Xenoah/pcb_voice-pitcher/docs/releases/v0.1.0-prototype.md

# Voice Pitcher Rev 0.1 — engineering prototype

98 × 98 mm・4層・表面実装のスタンドアローン音声DSP基板です。スクリーンショット全18枚を本文とAssetsに掲載しました。

これは実機未検証のプレリリースです。ERC/DRC/未接続は0件、ファームウェアのビルドとDSP合成音テストは通過しています。音質・遅延・USB互換性・消費電流は未測定で、量産承認済みではありません。

Assetsには全データZIP、ガーバーZIP、BOM/CPL、回路図、日本語説明書、ファームウェア、画像ZIPと個別PNGを含みます。`voice_pitcher_rev0.1_prototype.zip` でソースと製造資料を一括取得できます。部品調達とCPL方向のレビューを済ませてから試作してください。

実際のKiCadデータとPDFから出力した設計画面です。実機写真ではありません。3Dモデル未提供のJ1（USB-C）、J2/J3（音声ジャック）、Y1（発振器）、および外付けOLEDは3D表示に含まれません。

**3D斜視** — 98 × 98 mm、全ての部品を表面に実装する設計。

基板の3D斜視。CADレンダリング、未実機検証

**表裏・4層の一覧** — 上段は3D表裏、中段は表裏配線、下段はGND / 3.3 V内層。裏面図は裏側から見た向きです。

基板の表裏、配線、GNDと3.3V内層の一覧

**回路図全7ページと説明書** — 全体構成、MCU、電源、USB、コーデック、アナログ、表示・操作回路。

回路図全7ページと日本語説明書の一覧

<details>
<summary>個別の高解像度画像を表示</summary>

|3D表面|3D裏面|
|---|---|
|3D表面|3D裏面|
|表面配線|裏面配線|
|表面配線|裏面配線|
|L2 GND|L3 3.3 V|
|GND内層|3.3V内層|
|実装図|回路図：全体|
|実装図|全体構成|
|回路図：MCU|回路図：電源|
|MCU|電源|
|回路図：USB-C|回路図：コーデック|
|USB-C|コーデック|
|回路図：アナログ|回路図：OLED・スイッチ|
|アナログ|OLED・スイッチ|
|日本語説明書・先頭ページ|画像の生成元|
|日本語説明書|[CADハッシュ・3Dモデル出典・画像一覧](https://raw.githubusercontent.com/Xenoah/pcb_voice-pitcher/v0.1.0-prototype/downloads/screenshots/manifest.json)|

</details>
