Xenoah/pcb_voice-pitcher/downloads/bom_master.csv

ref | value | mpn | lcsc | footprint | assembly | sourcing_status | source_url
C1 | 100n | CC0603KRX7R9BB104 | C14663 | Capacitor_SMD:C_0603_1608Metric | SMT | BASIC | https://jlcpcb.com/partdetail/C14663
C2 | 10u | UWT1C100MCL1GB |  | Capacitor_SMD:CP_Elec_4x5.8 | SMT | UNVERIFIED
C3 | 10u | UWT1C100MCL1GB |  | Capacitor_SMD:CP_Elec_4x5.8 | SMT | UNVERIFIED
C4 | 100n | CC0603KRX7R9BB104 | C14663 | Capacitor_SMD:C_0603_1608Metric | SMT | BASIC | https://jlcpcb.com/partdetail/C14663
C5 | 10u | UWT1C100MCL1GB |  | Capacitor_SMD:CP_Elec_4x5.8 | SMT | UNVERIFIED
C6 | 100n | CC0603KRX7R9BB104 | C14663 | Capacitor_SMD:C_0603_1608Metric | SMT | BASIC | https://jlcpcb.com/partdetail/C14663
C7 | 100n | CC0603KRX7R9BB104 | C14663 | Capacitor_SMD:C_0603_1608Metric | SMT | BASIC | https://jlcpcb.com/partdetail/C14663
C8 | 100n | CC0603KRX7R9BB104 | C14663 | Capacitor_SMD:C_0603_1608Metric | SMT | BASIC | https://jlcpcb.com/partdetail/C14663
C9 | 100n | CC0603KRX7R9BB104 | C14663 | Capacitor_SMD:C_0603_1608Metric | SMT | BASIC | https://jlcpcb.com/partdetail/C14663
C10 | 100n | CC0603KRX7R9BB104 | C14663 | Capacitor_SMD:C_0603_1608Metric | SMT | BASIC | https://jlcpcb.com/partdetail/C14663
C11 | 100n | CC0603KRX7R9BB104 | C14663 | Capacitor_SMD:C_0603_1608Metric | SMT | BASIC | https://jlcpcb.com/partdetail/C14663
C12 | 100n | CC0603KRX7R9BB104 | C14663 | Capacitor_SMD:C_0603_1608Metric | SMT | BASIC | https://jlcpcb.com/partdetail/C14663
C13 | 1u | GRM188R71C105KA12D |  | Capacitor_SMD:C_0603_1608Metric | SMT | UNVERIFIED
C14 | 2.2u | GRM188R61C225KE15D |  | Capacitor_SMD:C_0603_1608Metric | SMT | UNVERIFIED
C15 | 2.2u | GRM188R61C225KE15D |  | Capacitor_SMD:C_0603_1608Metric | SMT | UNVERIFIED
C16 | 4.7u | GRM188R61C475KE11D |  | Capacitor_SMD:C_0603_1608Metric | SMT | UNVERIFIED
C17 | 100n | CC0603KRX7R9BB104 | C14663 | Capacitor_SMD:C_0603_1608Metric | SMT | BASIC | https://jlcpcb.com/partdetail/C14663
C18 | 100n | CC0603KRX7R9BB104 | C14663 | Capacitor_SMD:C_0603_1608Metric | SMT | BASIC | https://jlcpcb.com/partdetail/C14663
C19 | 100n | CC0603KRX7R9BB104 | C14663 | Capacitor_SMD:C_0603_1608Metric | SMT | BASIC | https://jlcpcb.com/partdetail/C14663
C20 | 100n | CC0603KRX7R9BB104 | C14663 | Capacitor_SMD:C_0603_1608Metric | SMT | BASIC | https://jlcpcb.com/partdetail/C14663
C21 | 10u | UWT1C100MCL1GB |  | Capacitor_SMD:CP_Elec_4x5.8 | SMT | UNVERIFIED
C22 | 100n | CC0603KRX7R9BB104 | C14663 | Capacitor_SMD:C_0603_1608Metric | SMT | BASIC | https://jlcpcb.com/partdetail/C14663
C23 | 100n | CC0603KRX7R9BB104 | C14663 | Capacitor_SMD:C_0603_1608Metric | SMT | BASIC | https://jlcpcb.com/partdetail/C14663
C24 | 470p | GRM1885C1H471JA01D |  | Capacitor_SMD:C_0603_1608Metric | SMT | UNVERIFIED
C25 | 4.7u | UWT1C4R7MCL1GB |  | Capacitor_SMD:CP_Elec_4x5.8 | SMT | UNVERIFIED
C26 | 2.2n | GRM1885C1H222JA01D |  | Capacitor_SMD:C_0603_1608Metric | SMT | UNVERIFIED
C29 | 470p | GRM1885C1H471JA01D |  | Capacitor_SMD:C_0603_1608Metric | SMT | UNVERIFIED
C30 | 4.7u | UWT1C4R7MCL1GB |  | Capacitor_SMD:CP_Elec_4x5.8 | SMT | UNVERIFIED
C31 | 2.2n | GRM1885C1H222JA01D |  | Capacitor_SMD:C_0603_1608Metric | SMT | UNVERIFIED
C34 | 100n | CC0603KRX7R9BB104 | C14663 | Capacitor_SMD:C_0603_1608Metric | SMT | BASIC | https://jlcpcb.com/partdetail/C14663
C35 | 1n | GRM1885C1H102JA01D |  | Capacitor_SMD:C_0603_1608Metric | SMT | UNVERIFIED
C36 | 10u | UWT1C100MCL1GB |  | Capacitor_SMD:CP_Elec_4x5.8 | SMT | UNVERIFIED
C40 | 1n | GRM1885C1H102JA01D |  | Capacitor_SMD:C_0603_1608Metric | SMT | UNVERIFIED
C41 | 10u | UWT1C100MCL1GB |  | Capacitor_SMD:CP_Elec_4x5.8 | SMT | UNVERIFIED
C42 | 100n | CC0603KRX7R9BB104 | C14663 | Capacitor_SMD:C_0603_1608Metric | SMT | BASIC | https://jlcpcb.com/partdetail/C14663
C43 | 100n | CC0603KRX7R9BB104 | C14663 | Capacitor_SMD:C_0603_1608Metric | SMT | BASIC | https://jlcpcb.com/partdetail/C14663
C44 | 100n | CC0603KRX7R9BB104 | C14663 | Capacitor_SMD:C_0603_1608Metric | SMT | BASIC | https://jlcpcb.com/partdetail/C14663
C45 | 100n | CC0603KRX7R9BB104 | C14663 | Capacitor_SMD:C_0603_1608Metric | SMT | BASIC | https://jlcpcb.com/partdetail/C14663
C46 | 100n | CC0603KRX7R9BB104 | C14663 | Capacitor_SMD:C_0603_1608Metric | SMT | BASIC | https://jlcpcb.com/partdetail/C14663
C47 | 1u | GRM188R71C105KA12D |  | Capacitor_SMD:C_0603_1608Metric | SMT | UNVERIFIED
C48 | 10n | GRM188R71E103KA01D |  | Capacitor_SMD:C_0603_1608Metric | SMT | UNVERIFIED
D1 | GREEN | LTST-C190KGKT |  | LED_SMD:LED_0603_1608Metric | SMT | UNVERIFIED
F1 | 500mA PTC | 1206L050YR |  | Fuse:Fuse_1206_3216Metric | SMT | UNVERIFIED
FB1 | 120R@100MHz | BLM21PG121SN1D |  | Inductor_SMD:L_0805_2012Metric | SMT | UNVERIFIED
FB2 | 120R@100MHz | BLM21PG121SN1D |  | Inductor_SMD:L_0805_2012Metric | SMT | UNVERIFIED
H1 | M3 NPTH | M3 NPTH |  | MountingHole:MountingHole_3.2mm_M3 | MECHANICAL | MECHANICAL
H2 | M3 NPTH | M3 NPTH |  | MountingHole:MountingHole_3.2mm_M3 | MECHANICAL | MECHANICAL
H3 | M3 NPTH | M3 NPTH |  | MountingHole:MountingHole_3.2mm_M3 | MECHANICAL | MECHANICAL
H4 | M3 NPTH | M3 NPTH |  | MountingHole:MountingHole_3.2mm_M3 | MECHANICAL | MECHANICAL
J1 | USB-C USB2 DEVICE | TYPE-C-31-M-12 | C165948 | Connector_USB:USB_C_Receptacle_HRO_TYPE-C-31-M-12 | SMT | JLC_LISTED | https://jlcpcb.com/partdetail/C165948
J2 | 3.5mm STEREO IN | SJ-3523-SMT-TR |  | Connector_Audio:Jack_3.5mm_CUI_SJ-3523-SMT_Horizontal | SMT | UNVERIFIED
J3 | 3.5mm STEREO OUT | SJ-3523-SMT-TR |  | Connector_Audio:Jack_3.5mm_CUI_SJ-3523-SMT_Horizontal | SMT | UNVERIFIED
J4 | OLED GND VCC SCL SDA | 1x4 2.54mm OLED socket |  | Connector_PinHeader_2.54mm:PinHeader_1x04_P2.54mm_Vertical | HAND | HAND
J5 | SWD | 1x6 2.54mm header |  | Connector_PinHeader_2.54mm:PinHeader_1x06_P2.54mm_Vertical | HAND | HAND
J6 | UART 3V3 | 1x3 2.54mm header |  | Connector_PinHeader_2.54mm:PinHeader_1x03_P2.54mm_Vertical | HAND | HAND
R1 | 5.1k | 0603WAF5101T5E | C23186 | Resistor_SMD:R_0603_1608Metric | SMT | BASIC | https://jlcpcb.com/partdetail/C23186
R2 | 5.1k | 0603WAF5101T5E | C23186 | Resistor_SMD:R_0603_1608Metric | SMT | BASIC | https://jlcpcb.com/partdetail/C23186
R3 | 1k | 0603WAF1001T5E | C21190 | Resistor_SMD:R_0603_1608Metric | SMT | BASIC | https://jlcpcb.com/partdetail/C21190
R4 | 1k | 0603WAF1001T5E | C21190 | Resistor_SMD:R_0603_1608Metric | SMT | BASIC | https://jlcpcb.com/partdetail/C21190
R5 | 22 | 0603WAF220JT5E | C23345 | Resistor_SMD:R_0603_1608Metric | SMT | BASIC | https://jlcpcb.com/partdetail/C23345
R6 | 22 | 0603WAF220JT5E | C23345 | Resistor_SMD:R_0603_1608Metric | SMT | BASIC | https://jlcpcb.com/partdetail/C23345
R7 | 100k | 0603WAF1003T5E | C25803 | Resistor_SMD:R_0603_1608Metric | SMT | BASIC | https://jlcpcb.com/partdetail/C25803
R8 | 100k | 0603WAF1003T5E | C25803 | Resistor_SMD:R_0603_1608Metric | SMT | BASIC | https://jlcpcb.com/partdetail/C25803
R9 | 33 | 0603WAF330JT5E | C23140 | Resistor_SMD:R_0603_1608Metric | SMT | JLC_LISTED | https://jlcpcb.com/partdetail/C23140
R10 | 10k | 0603WAF1002T5E | C25804 | Resistor_SMD:R_0603_1608Metric | SMT | BASIC | https://jlcpcb.com/partdetail/C25804
R11 | 10k | 0603WAF1002T5E | C25804 | Resistor_SMD:R_0603_1608Metric | SMT | BASIC | https://jlcpcb.com/partdetail/C25804
R12 | 220k | 0603WAF2203T5E | C22961 | Resistor_SMD:R_0603_1608Metric | SMT | JLC_LISTED | https://jlcpcb.com/partdetail/C22961
R13 | 10k | 0603WAF1002T5E | C25804 | Resistor_SMD:R_0603_1608Metric | SMT | BASIC | https://jlcpcb.com/partdetail/C25804
R14 | 33 | 0603WAF330JT5E | C23140 | Resistor_SMD:R_0603_1608Metric | SMT | JLC_LISTED | https://jlcpcb.com/partdetail/C23140
R15 | 33 | 0603WAF330JT5E | C23140 | Resistor_SMD:R_0603_1608Metric | SMT | JLC_LISTED | https://jlcpcb.com/partdetail/C23140
R16 | 33 | 0603WAF330JT5E | C23140 | Resistor_SMD:R_0603_1608Metric | SMT | JLC_LISTED | https://jlcpcb.com/partdetail/C23140
R17 | 33 | 0603WAF330JT5E | C23140 | Resistor_SMD:R_0603_1608Metric | SMT | JLC_LISTED | https://jlcpcb.com/partdetail/C23140
R20 | 10k | 0603WAF1002T5E | C25804 | Resistor_SMD:R_0603_1608Metric | SMT | BASIC | https://jlcpcb.com/partdetail/C25804
R21 | 10k | 0603WAF1002T5E | C25804 | Resistor_SMD:R_0603_1608Metric | SMT | BASIC | https://jlcpcb.com/partdetail/C25804
R22 | 100k | 0603WAF1003T5E | C25803 | Resistor_SMD:R_0603_1608Metric | SMT | BASIC | https://jlcpcb.com/partdetail/C25803
R23 | 100 | 0603WAF1000T5E | C22775 | Resistor_SMD:R_0603_1608Metric | SMT | BASIC | https://jlcpcb.com/partdetail/C22775
R25 | 10k | 0603WAF1002T5E | C25804 | Resistor_SMD:R_0603_1608Metric | SMT | BASIC | https://jlcpcb.com/partdetail/C25804
R26 | 10k | 0603WAF1002T5E | C25804 | Resistor_SMD:R_0603_1608Metric | SMT | BASIC | https://jlcpcb.com/partdetail/C25804
R27 | 100k | 0603WAF1003T5E | C25803 | Resistor_SMD:R_0603_1608Metric | SMT | BASIC | https://jlcpcb.com/partdetail/C25803
R28 | 100 | 0603WAF1000T5E | C22775 | Resistor_SMD:R_0603_1608Metric | SMT | BASIC | https://jlcpcb.com/partdetail/C22775
R30 | 3.3k | 0603WAF3301T5E | C22978 | Resistor_SMD:R_0603_1608Metric | SMT | BASIC | https://jlcpcb.com/partdetail/C22978
R31 | 100 | 0603WAF1000T5E | C22775 | Resistor_SMD:R_0603_1608Metric | SMT | BASIC | https://jlcpcb.com/partdetail/C22775
R32 | 100k | 0603WAF1003T5E | C25803 | Resistor_SMD:R_0603_1608Metric | SMT | BASIC | https://jlcpcb.com/partdetail/C25803
R35 | 3.3k | 0603WAF3301T5E | C22978 | Resistor_SMD:R_0603_1608Metric | SMT | BASIC | https://jlcpcb.com/partdetail/C22978
R36 | 100 | 0603WAF1000T5E | C22775 | Resistor_SMD:R_0603_1608Metric | SMT | BASIC | https://jlcpcb.com/partdetail/C22775
R37 | 100k | 0603WAF1003T5E | C25803 | Resistor_SMD:R_0603_1608Metric | SMT | BASIC | https://jlcpcb.com/partdetail/C25803
R40 | 4.7k | 0603WAF4701T5E | C23162 | Resistor_SMD:R_0603_1608Metric | SMT | BASIC | https://jlcpcb.com/partdetail/C23162
R41 | 4.7k | 0603WAF4701T5E | C23162 | Resistor_SMD:R_0603_1608Metric | SMT | BASIC | https://jlcpcb.com/partdetail/C23162
R42 | 10k | 0603WAF1002T5E | C25804 | Resistor_SMD:R_0603_1608Metric | SMT | BASIC | https://jlcpcb.com/partdetail/C25804
R43 | 10k | 0603WAF1002T5E | C25804 | Resistor_SMD:R_0603_1608Metric | SMT | BASIC | https://jlcpcb.com/partdetail/C25804
R44 | 10k | 0603WAF1002T5E | C25804 | Resistor_SMD:R_0603_1608Metric | SMT | BASIC | https://jlcpcb.com/partdetail/C25804
R45 | 10k | 0603WAF1002T5E | C25804 | Resistor_SMD:R_0603_1608Metric | SMT | BASIC | https://jlcpcb.com/partdetail/C25804
R46 | 1k | 0603WAF1001T5E | C21190 | Resistor_SMD:R_0603_1608Metric | SMT | BASIC | https://jlcpcb.com/partdetail/C21190
SW1 | RESET | TL3342F160QG |  | Button_Switch_SMD:SW_SPST_TL3342 | SMT | UNVERIFIED
SW2 | BOOT | TL3342F160QG |  | Button_Switch_SMD:SW_SPST_TL3342 | SMT | UNVERIFIED
SW3 | MODE | TL3342F160QG |  | Button_Switch_SMD:SW_SPST_TL3342 | SMT | UNVERIFIED
SW4 | DOWN | TL3342F160QG |  | Button_Switch_SMD:SW_SPST_TL3342 | SMT | UNVERIFIED
SW5 | UP | TL3342F160QG |  | Button_Switch_SMD:SW_SPST_TL3342 | SMT | UNVERIFIED
SW6 | IO | TL3342F160QG |  | Button_Switch_SMD:SW_SPST_TL3342 | SMT | UNVERIFIED
U1 | STM32H743VIT6 | STM32H743VIT6 | C114409 | Package_QFP:LQFP-100_14x14mm_P0.5mm | SMT | JLC_LISTED | https://jlcpcb.com/partdetail/C114409
U2 | PCM3060PWR | PCM3060PWR | C2651841 | Package_SO:TSSOP-28_4.4x9.7mm_P0.65mm | SMT | LCSC_LISTED_JLC_UNCONFIRMED | https://www.lcsc.com/product-detail/C2651841.html
U3 | USBLC6-2SC6 | USBLC6-2SC6 | C7519 | Package_TO_SOT_SMD:SOT-23-6 | SMT | JLC_LISTED | https://jlcpcb.com/partdetail/C7519
U4 | LD1117S33TR | LD1117S33TR |  | Package_TO_SOT_SMD:SOT-223-3_TabPin2 | SMT | UNVERIFIED
U5 | TLV9062IDR | TLV9062IDR |  | Package_SO:SOIC-8_3.9x4.9mm_P1.27mm | SMT | UNVERIFIED
U6 | TLV9062IDR | TLV9062IDR |  | Package_SO:SOIC-8_3.9x4.9mm_P1.27mm | SMT | UNVERIFIED
U7 | TPS22918DBVR | TPS22918DBVR |  | Package_TO_SOT_SMD:SOT-23-6 | SMT | UNVERIFIED
Y1 | 8MHz 3V3 CMOS | ASE-8.000MHZ-LC-T |  | Oscillator:Oscillator_SMD_Abracon_ASE-4Pin_3.2x2.5mm | SMT | UNVERIFIED
