Xenoah/pcb_voice-pitcher/docs/validation.md

# 検証記録と実機試験

## このリポジトリで実施済み

2026-11-01、Codex cloud environmentで実施。結果は `downloads/reports/` に保存しています。

|確認|結果|
|---|---|
|KiCad 9.0.2 ERC|0件|
|KiCad DRC / 未接続|0件 / 0件|
|回路図XMLとPCBの照合|377個の番号付きパッドを確認、意図的NCも照合|
|外形・層数・実装面|98 × 98 mm、4層、全107フットプリントTOP|
|BOMとCPL|SMT 100個のDesignator一致、ヘッダ・穴を除外|
|Arm GCC|Cortex-M7 hard-float、ELF/BIN/HEX生成成功|
|DSP単体|7音程のYIN検出、スケール選択、無音、NaN/範囲処理、長時間有限出力|
|デジタルDRY|入力floatと出力のバイト一致、24 bit整数→float→整数のサンプル照合|
|メモリ安全性|ホストのAddressSanitizer / UndefinedBehaviorSanitizerで検出なし|
|出力FFT|±12、+7、−5半音および単音補正2条件、全6条件で目標±15 cents以内|

FFTテストは3秒の合成正弦波を処理し、最初の1秒を除いた2秒を解析。今回の結果では全6条件で誤差1 cent未満です。音声・和音・過渡音の品質や、実機のアナログ性能を証明するものではありません。測定数値はJSONに保存しています。

ERCやDRCを黙らせるための一括違反除外は設定していません。PCM3060の多機能端子はハードウェアモードに合わせてDEMPを入力として表現し、未使用端子はNCにしています。電源入力には意図を明示するPWR_FLAGがあります。

## 実機で未検証の項目

試作前のレビュー項目と、試作後の合格条件を分けます。以下は結果欄が埋まるまで未完了です。

|順番|試験|確認内容・目標|
|---|---|---|
|1|無給電検査|5 V/3.3 VとGNDの短絡、極性、はんだブリッジ、取り付け方向|
|2|電源立ち上げ|電流制限5 V、3.3 V/VDDA/VCAP/VCOM、約26 msのスルー、異常発熱なし|
|3|電流と熱|未構成USB、構成後、単体、全エフェクト、OLED点灯、サスペンド各状態。LDO最高温度を記録|
|4|SWD・ブート|フラッシュverify、Reset、BOOT、異常時のリセット保持|
|5|クロック|HSE 8 MHz、MCLK 12.288 MHz、BCLK 3.072 MHz、LRCK 48 kHz、ジッタ・リンギング|
|6|デジタル音声|I²Sの24 bitとスロット位置、左右、符号、フルスケール、DMA処理期限|
|7|ラインDRY|1 kHz −12 dBFS相当から開始、左右利得・DC・クリップ点・周波数特性|
|8|音質|20 Hz～20 kHz、THD+N、SNR、クロストーク、電源/USB負荷変化。基板実測値を残す|
|9|遅延|ラインループバックのインパルス/相互相関、DRY/SHIFT/TUNE別、入力音程ごと|
|10|USB|Windows/macOS/Linux、必要なスマホ、入出力各ルート、48 kHz/24 bit、8時間連続、着脱・休止復帰|
|11|操作|4キーと長押し、表示欠落、OLEDなし、経路/モード切替時のポップ音|
|12|ピッチ補正|低音/高音/ビブラート/子音/雑音/和音。音程誤検出、フォルマント変化、帯域低下を試聴|

開発目標の目安はDRYアナログ往復3 ms未満、1 kHzでTHD+N −80 dB以下、A-weighted SNR 90 dB以上、各モードのDMA期限未超過です。これらは**受け入れ試験用の目標で、達成済み仕様ではありません**。ピッチ処理では品質と遅延の両方を記録して判断します。

USBのサスペンド電流、ESD/EMC、製品のVID/PID、部品代替、筐体機構は製品化時の追加作業です。現時点の `production_release` と `bench_validation` はどちらもfalseです。
