Xenoah/pcb_voice-pitcher/downloads/schematic.pdf

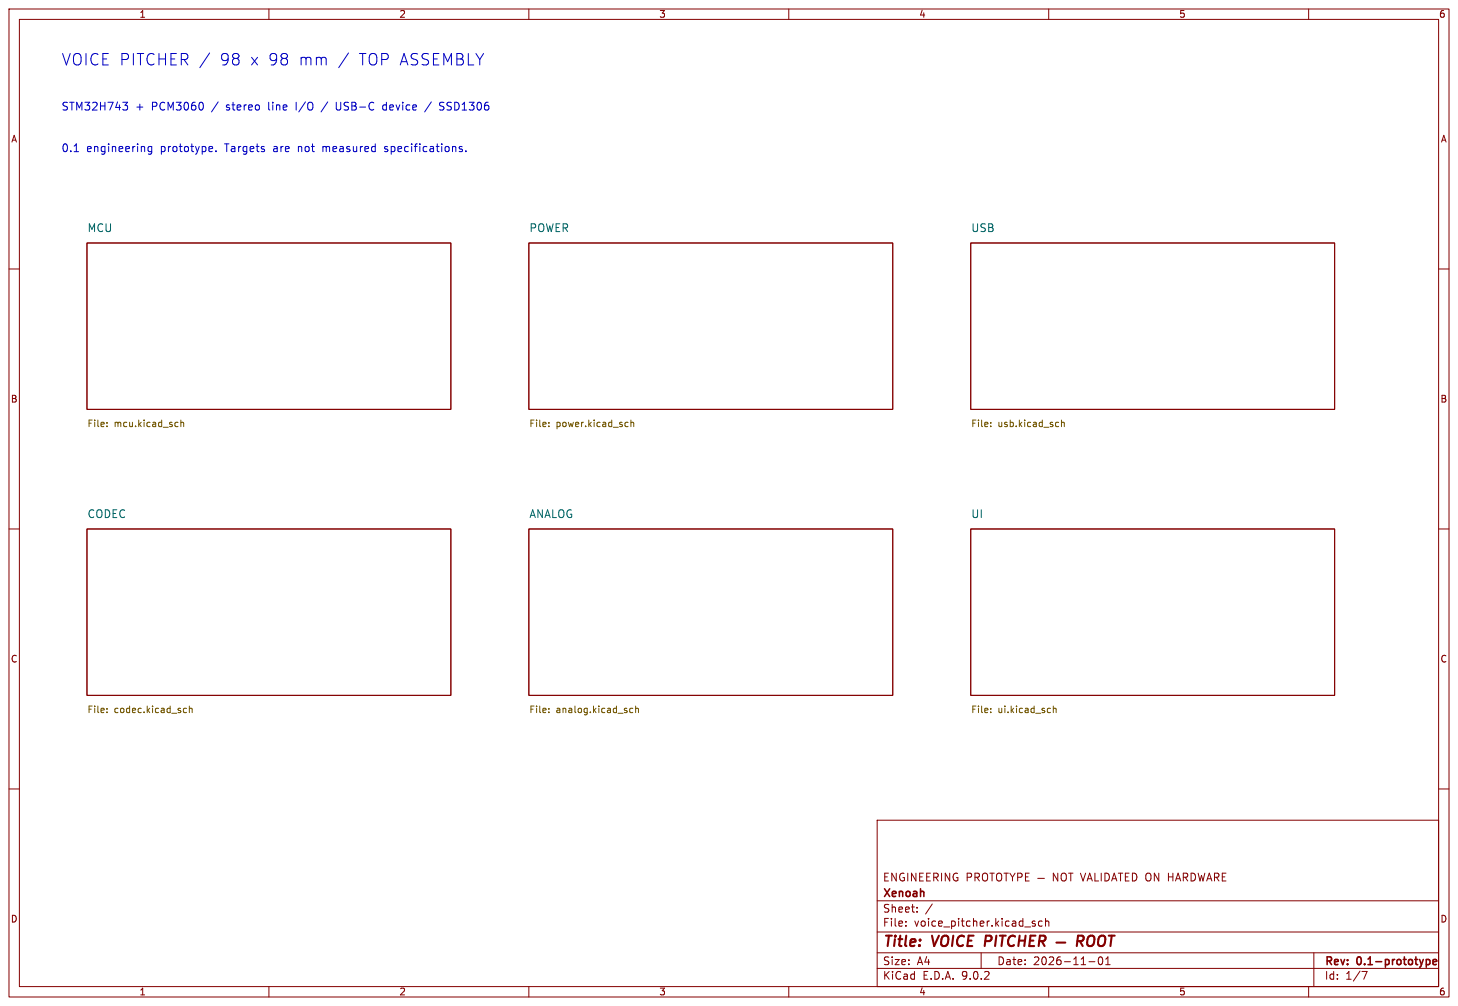
[picture p19: page 1]

Id: 1/7 Title: VOICE PITCHER þÿ ROOT

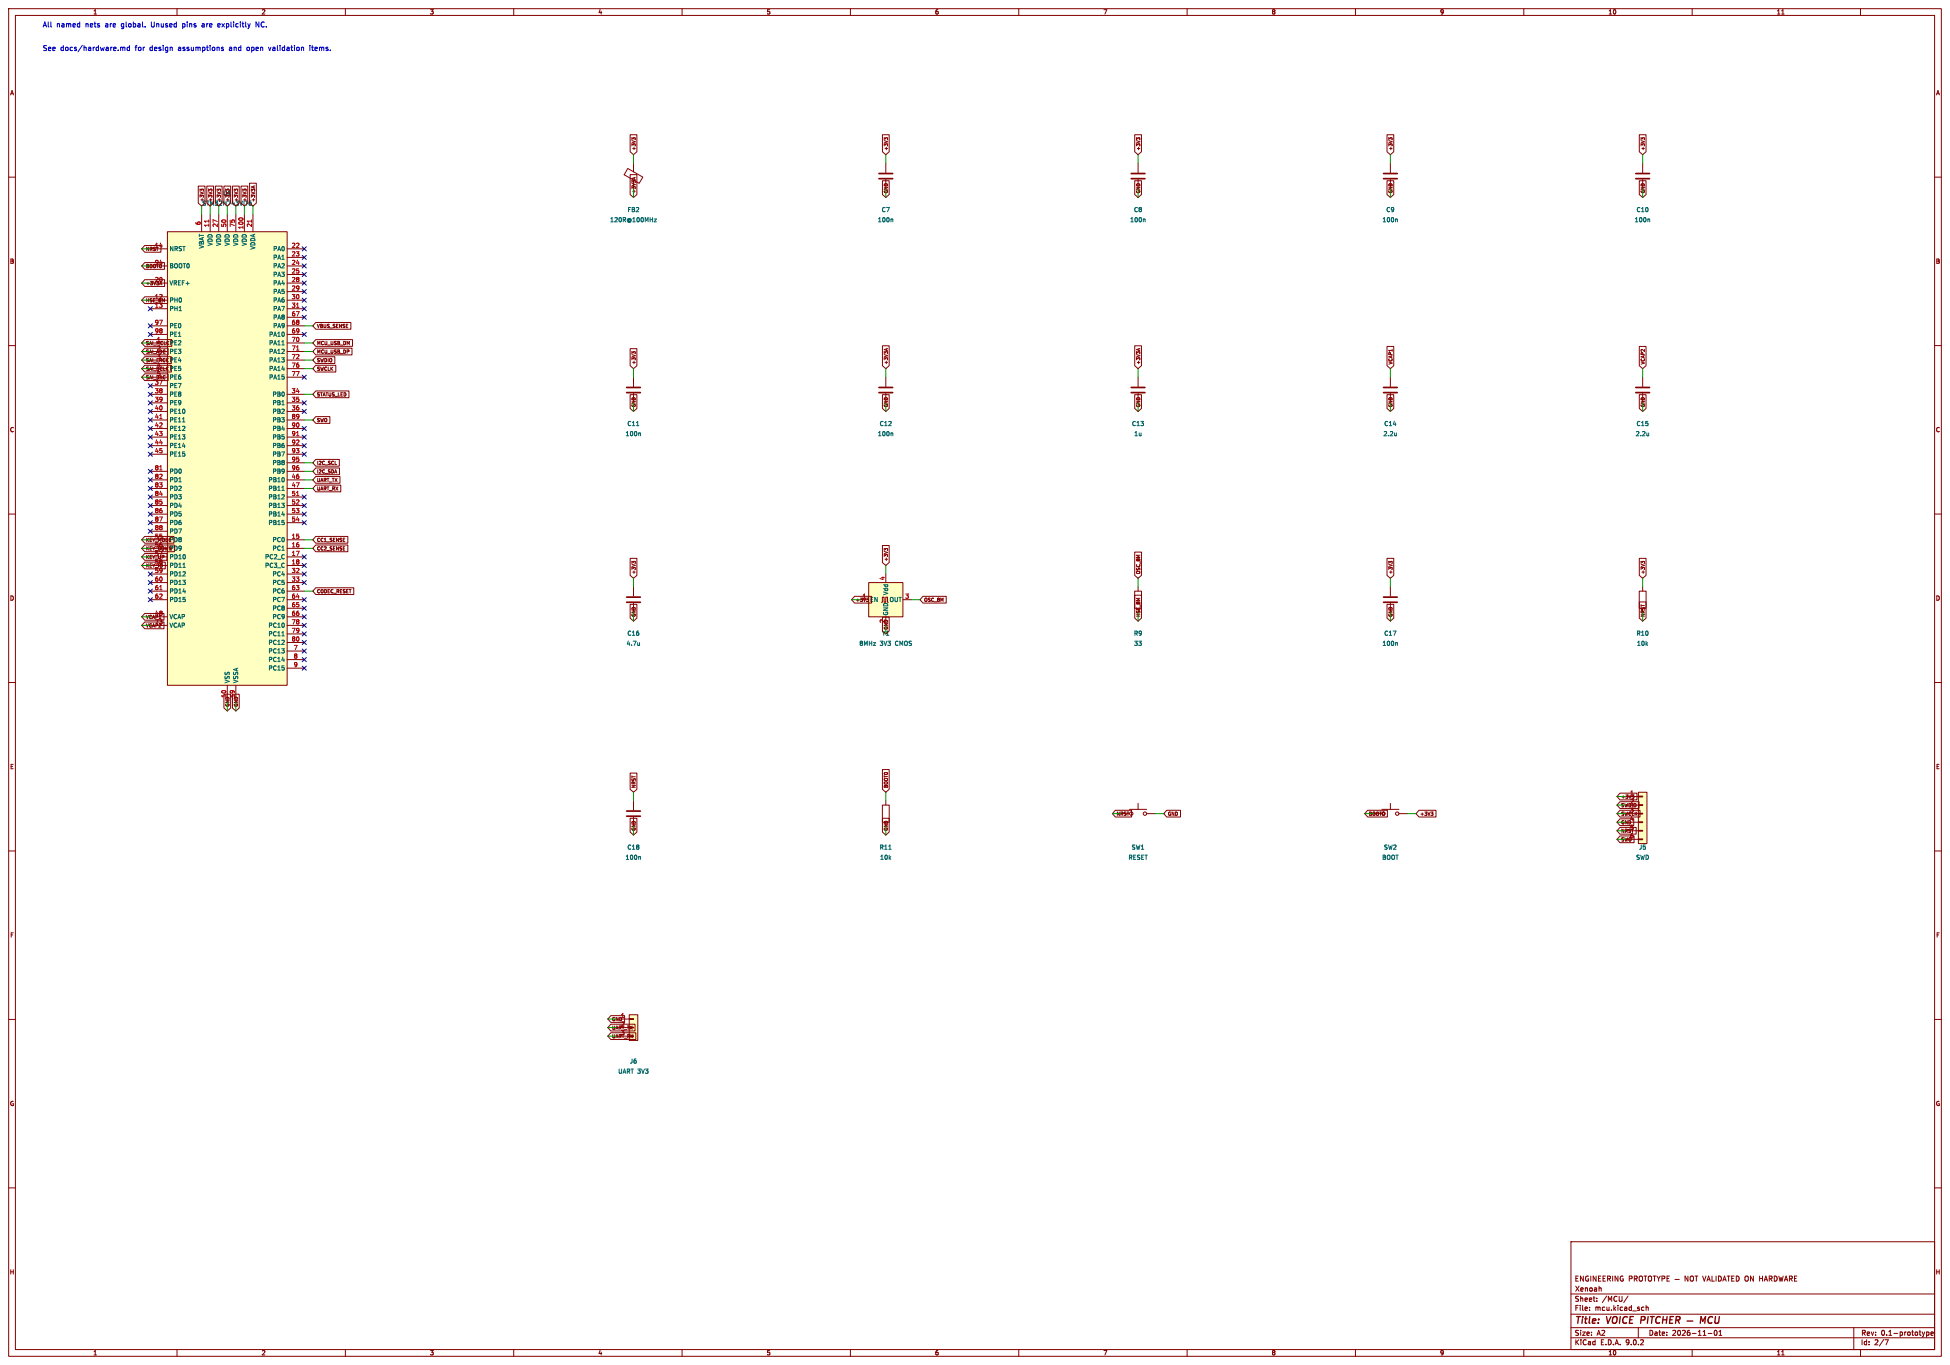
[picture p20: page 2]

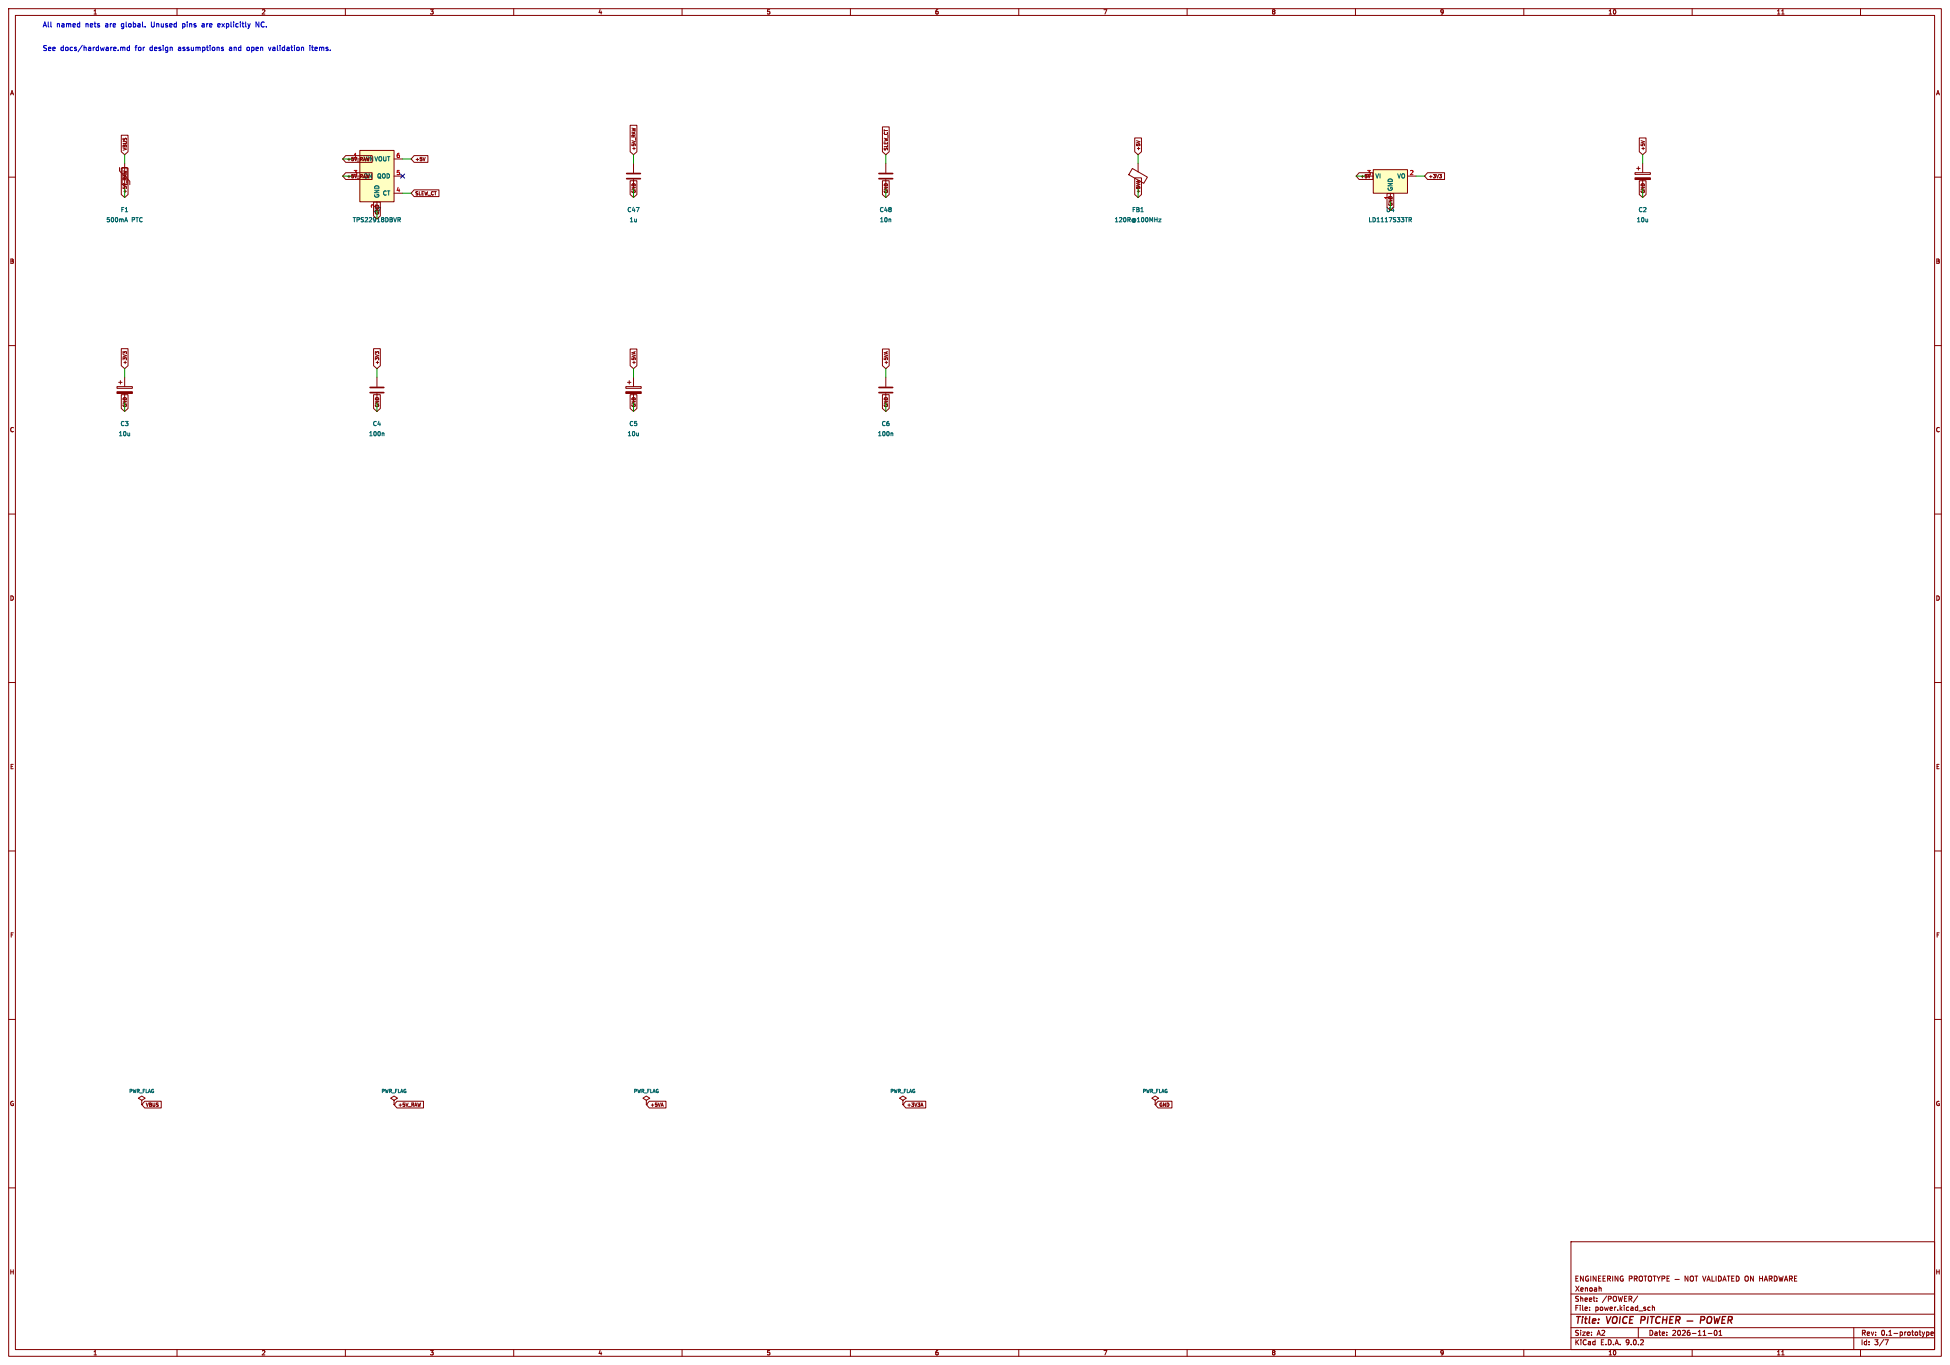
[picture p21: page 3]

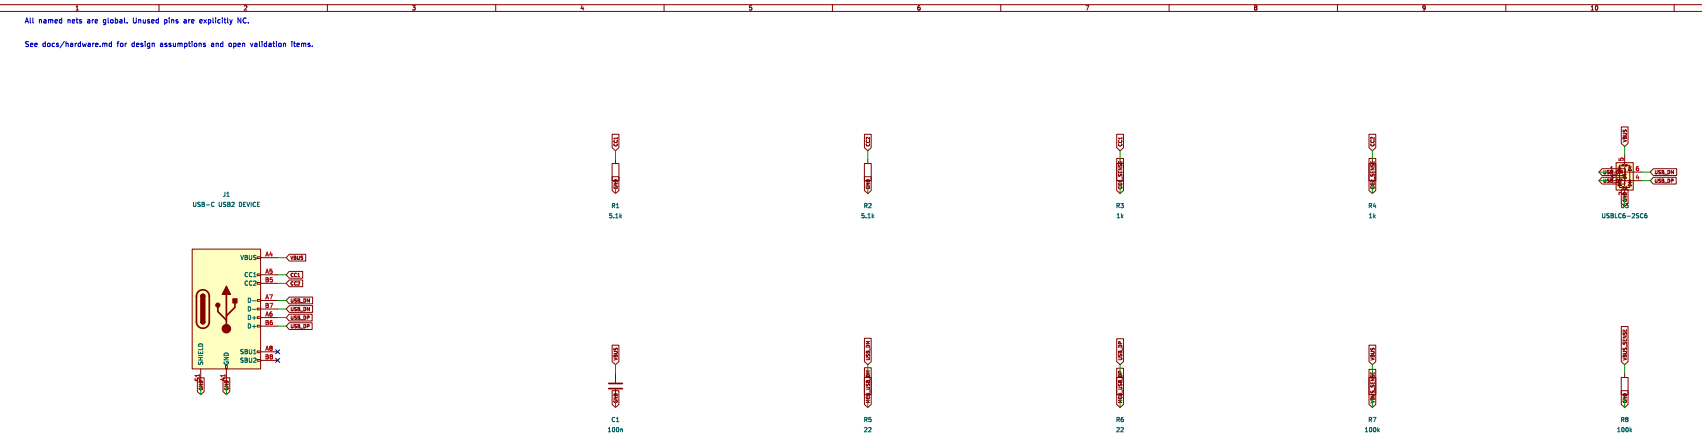
[picture p22: page 4]

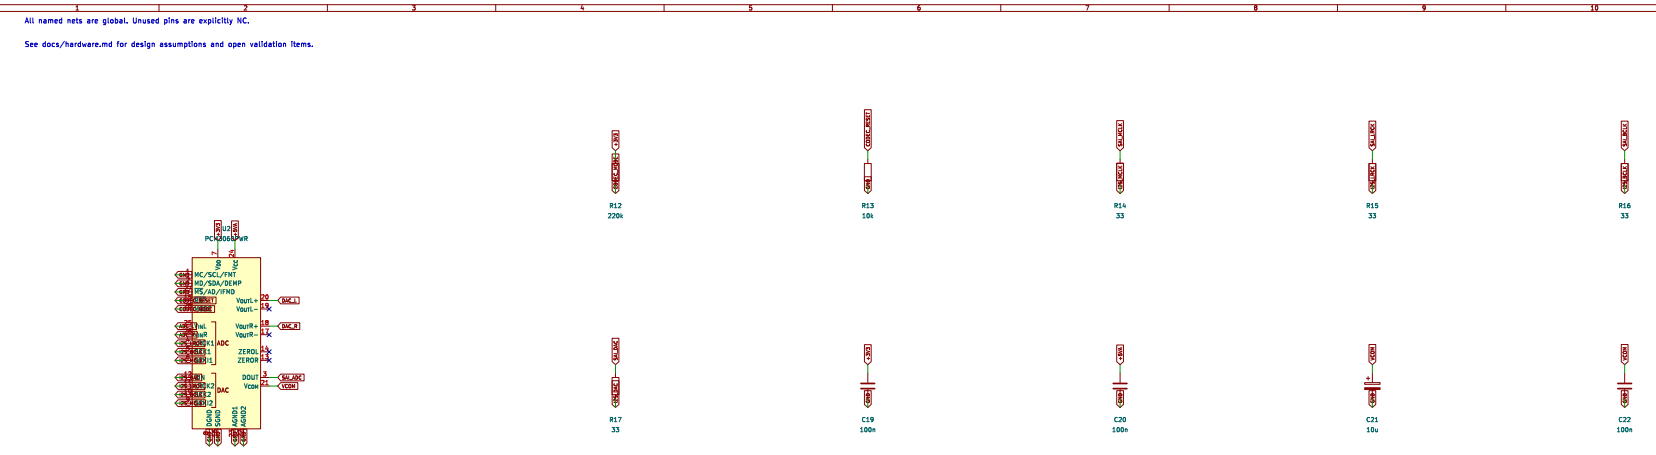
[picture p23: page 5]

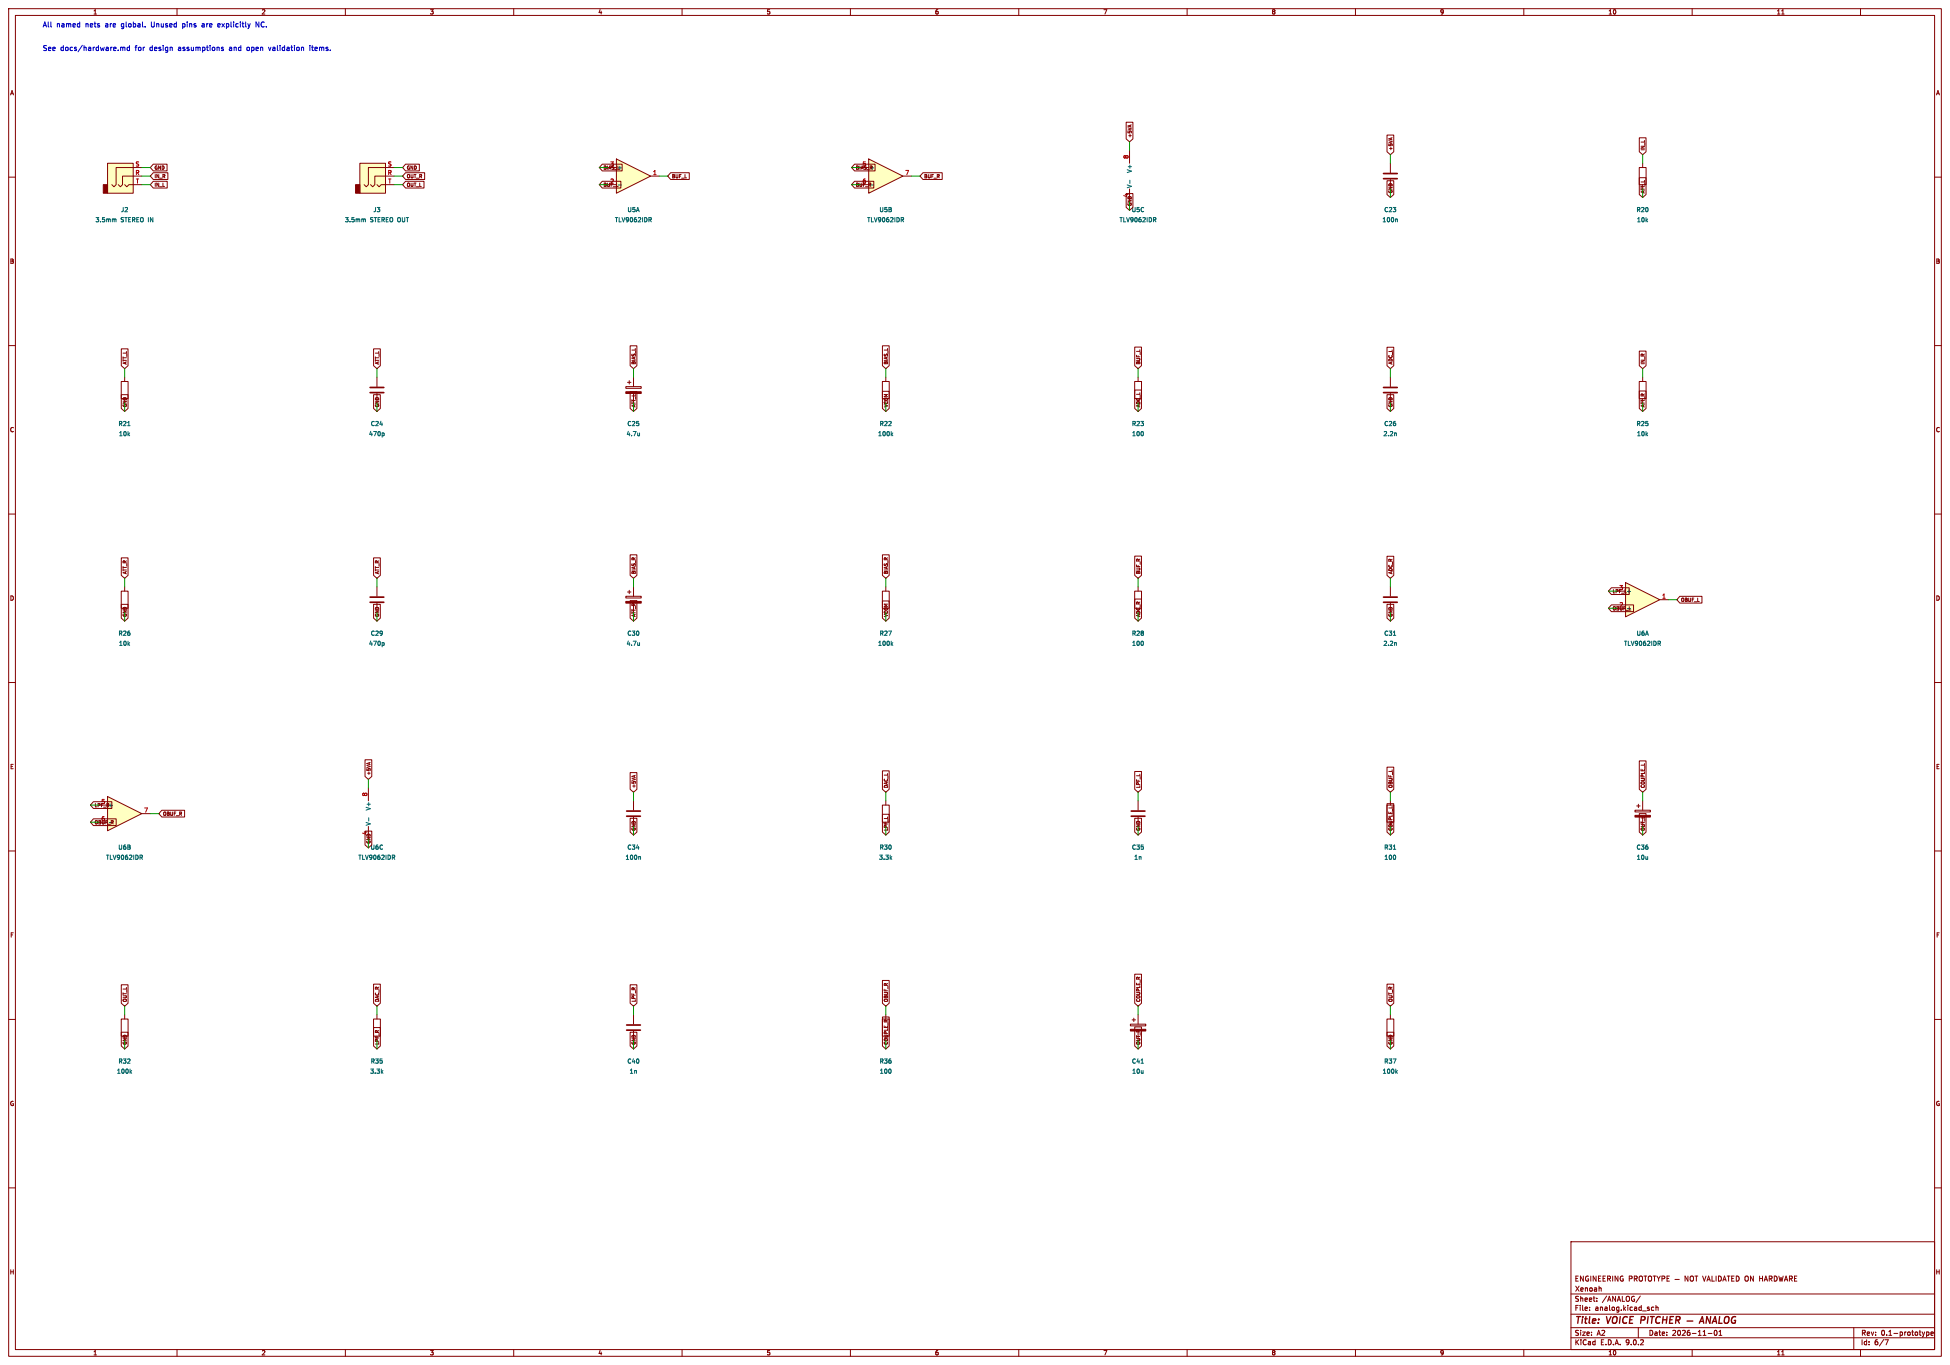
[picture p24: page 6]

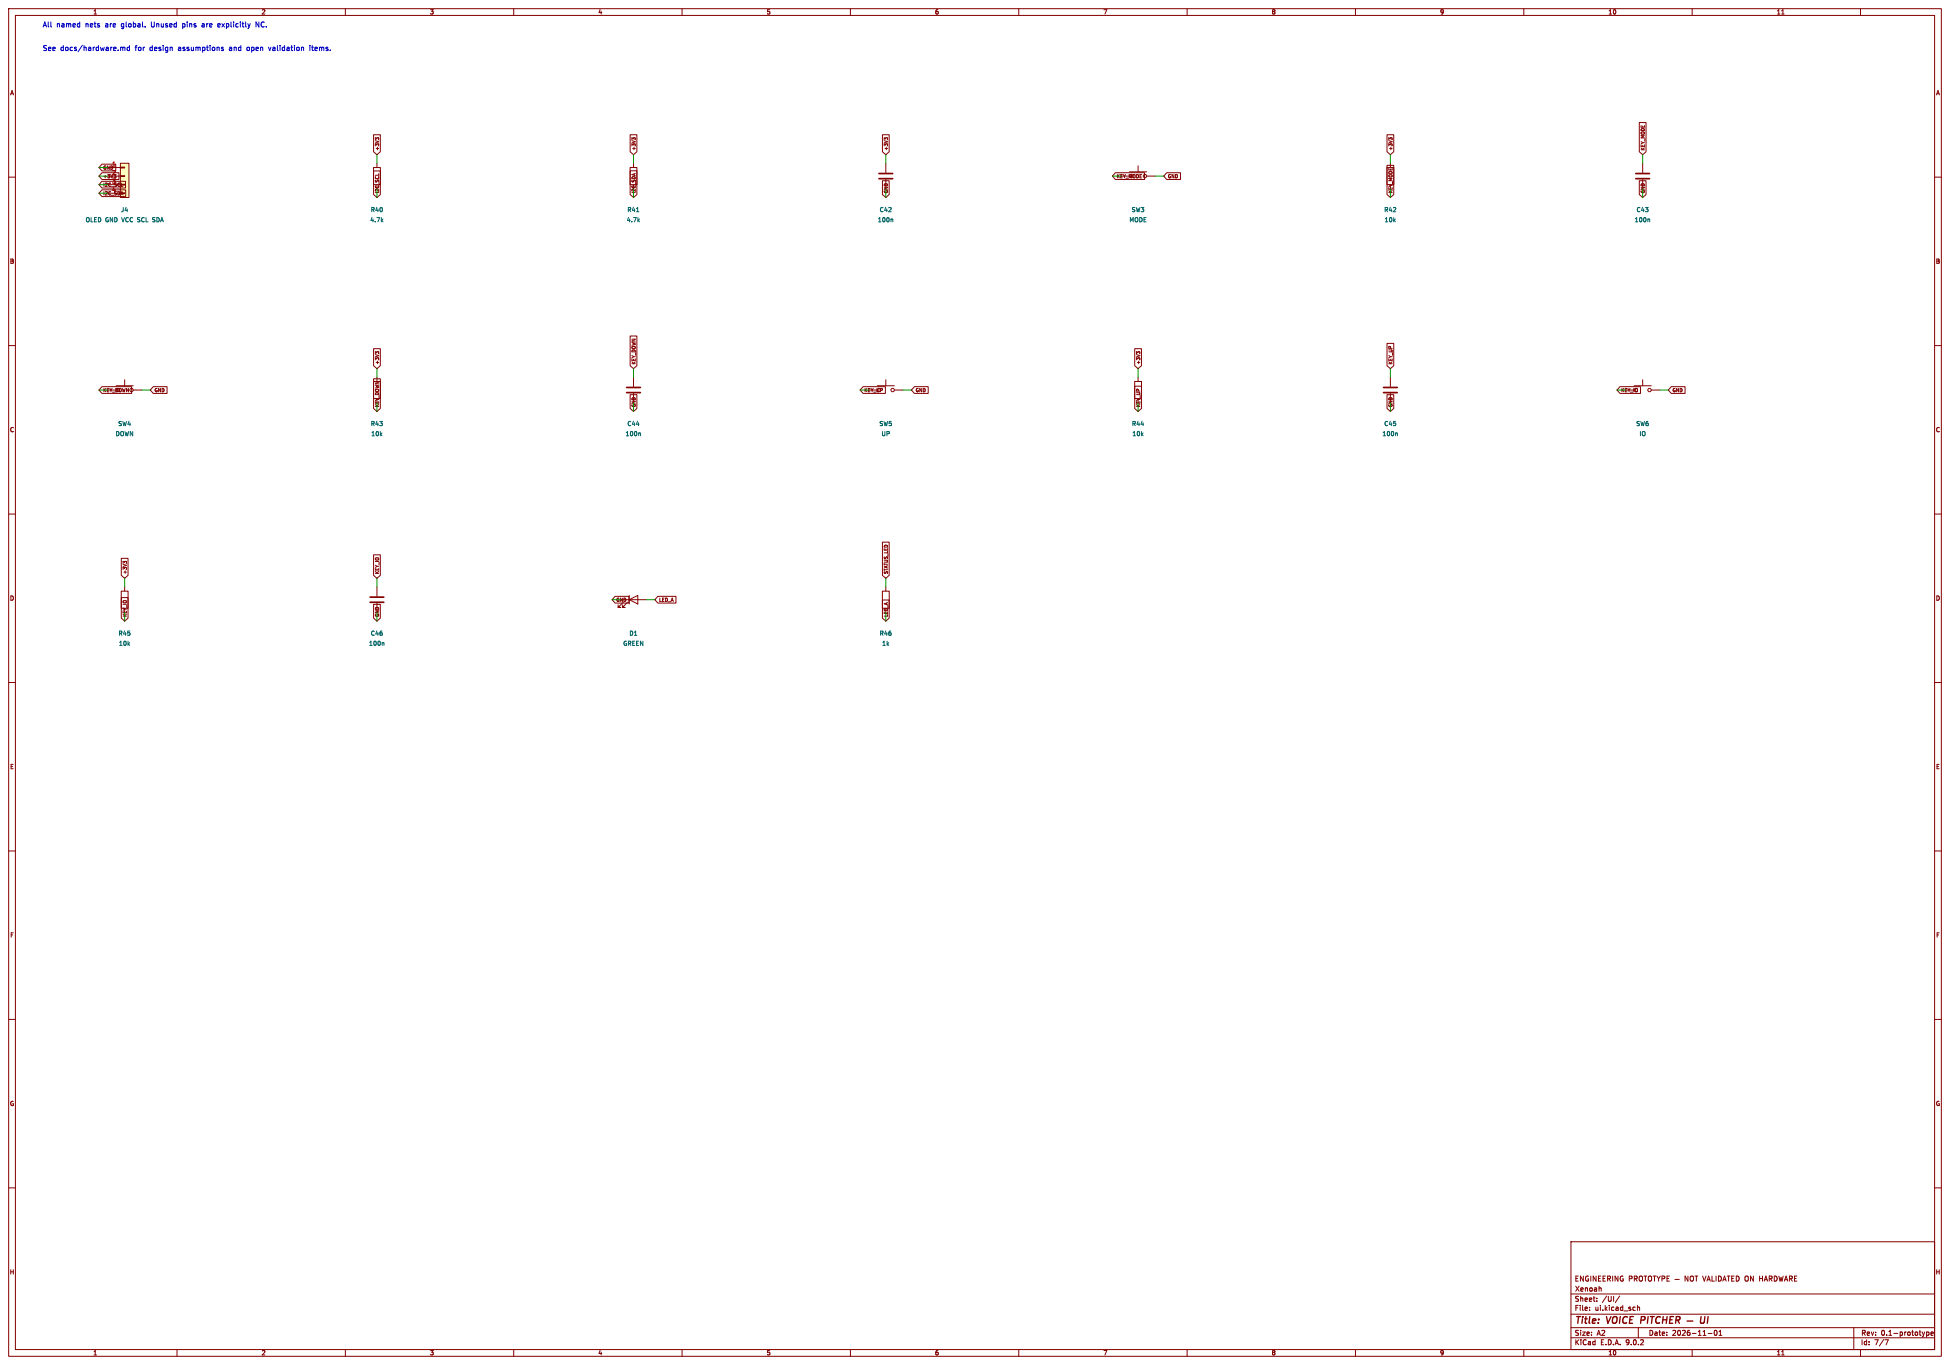
[picture p25: page 7]

J4 OLED GND VCC SCL SDA
