Xenoah/pcb_voice-pitcher/downloads/assembly-top.pdf

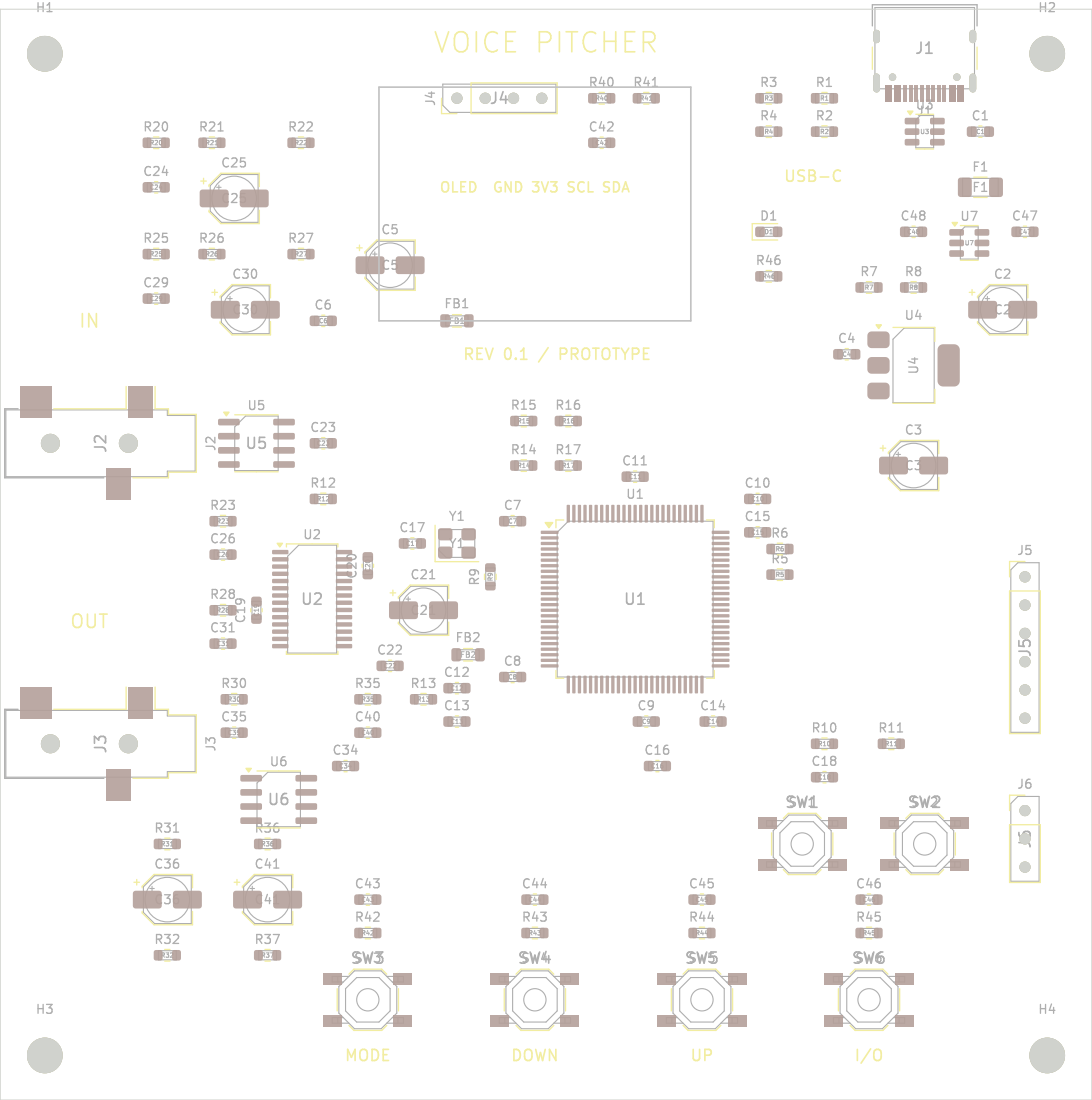
[picture p26: page 1]
