Xenoah/pcb_voice-pitcher/hardware/voice_pitcher.kicad_pcb

## KiCad design hardware/voice_pitcher.kicad_pcb (2026-11-01)

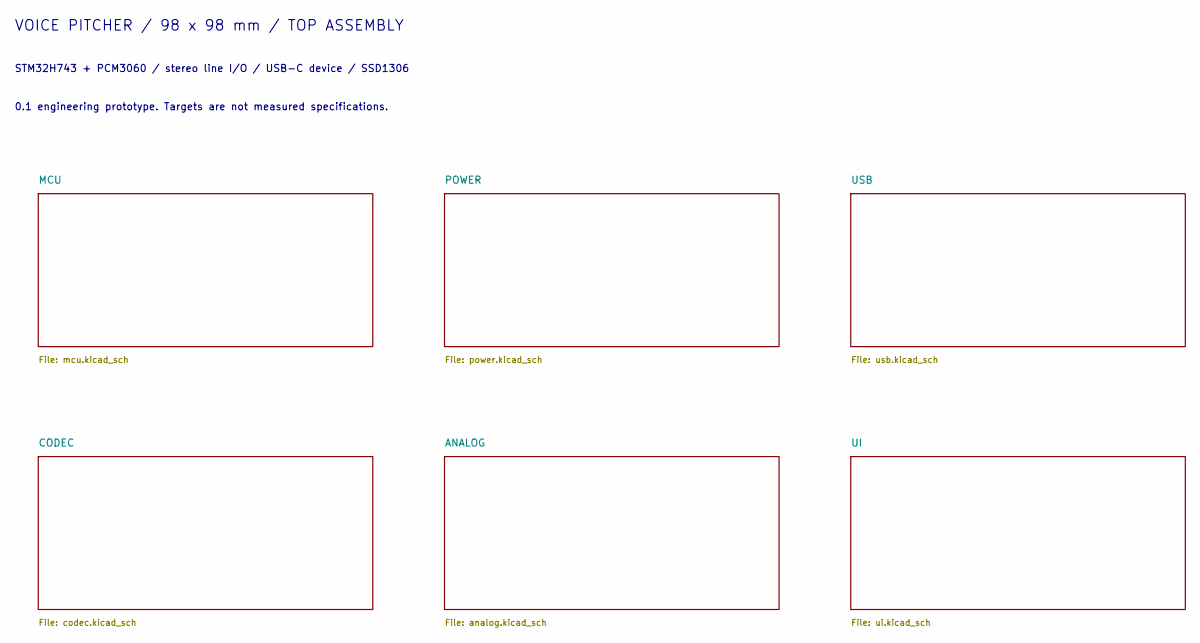
[picture p27: schematic voice_pitcher.kicad_sch, VOICE PITCHER — ROOT]

Notes on the sheet:
VOICE PITCHER / 98 x 98 mm / TOP ASSEMBLY
STM32H743 + PCM3060 / stereo line I/O / USB-C device / SSD1306
0.1 engineering prototype. Targets are not measured specifications.

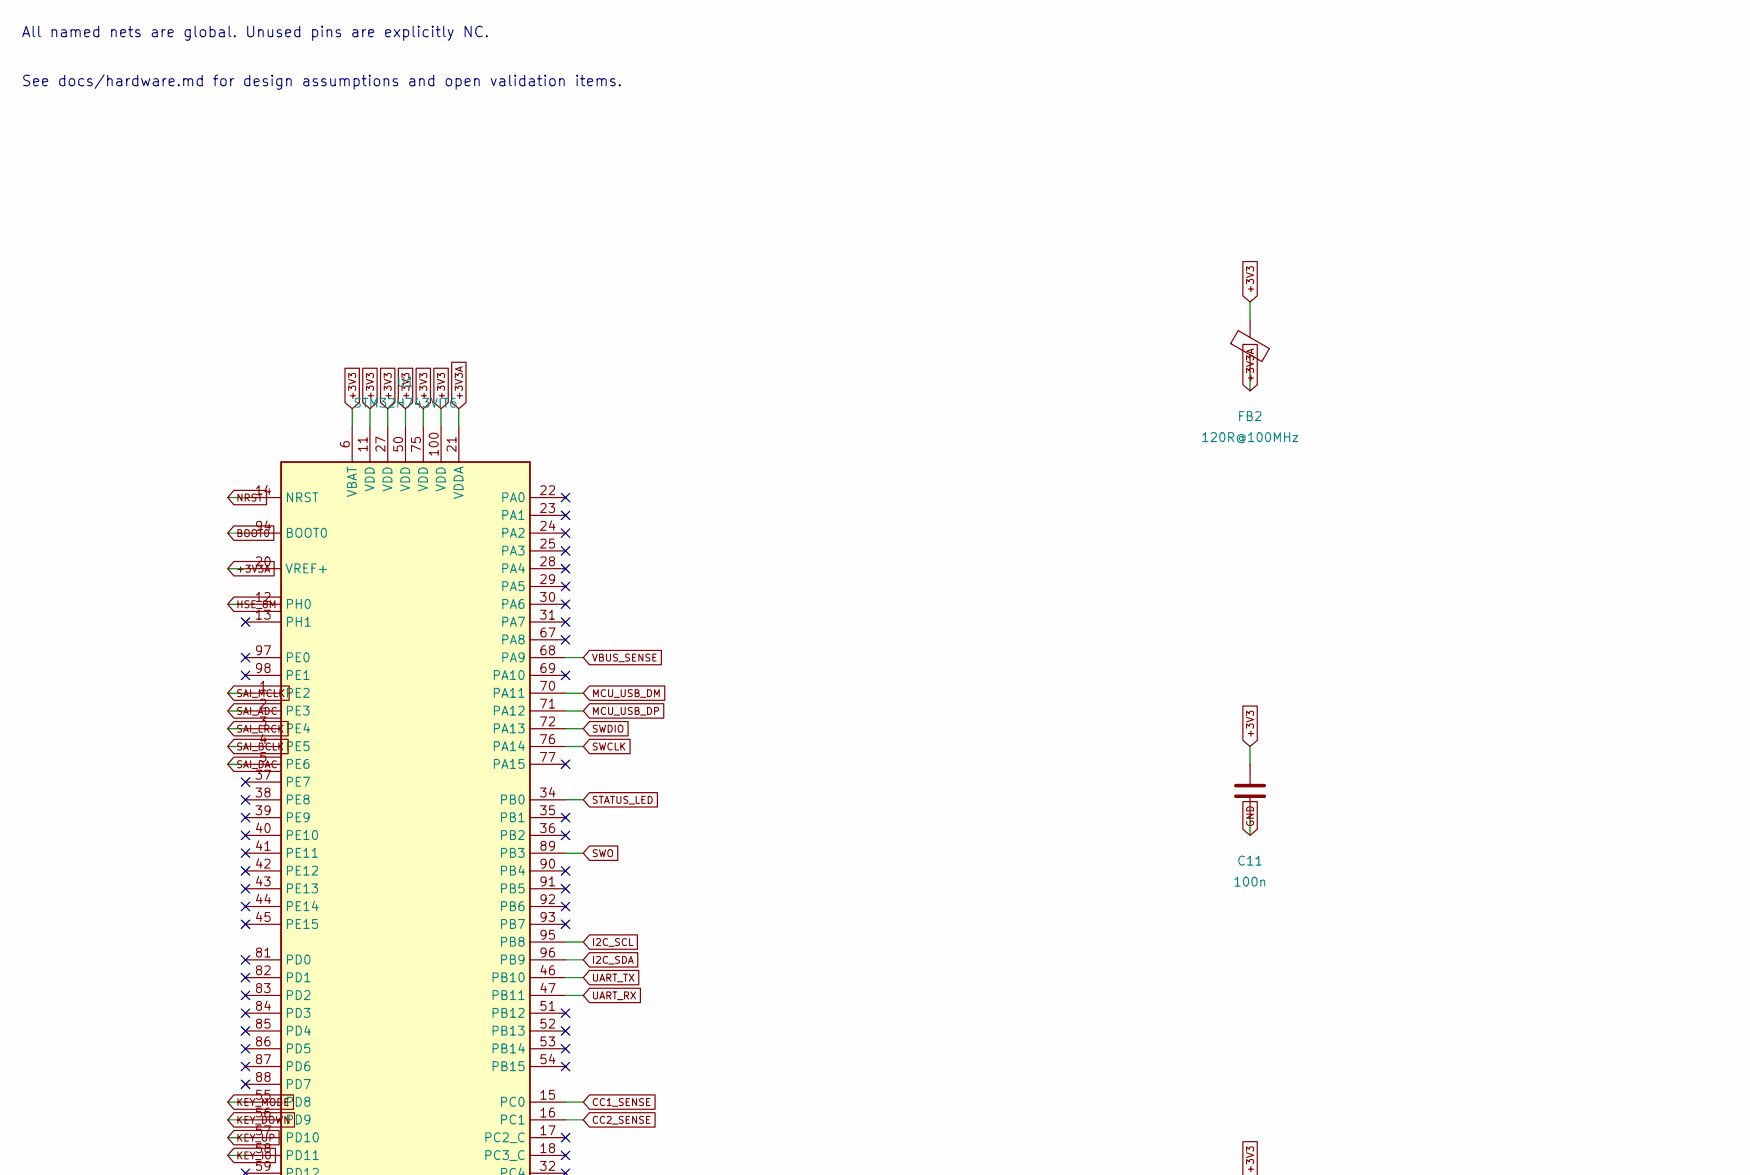
[picture p28: schematic mcu.kicad_sch, VOICE PITCHER — MCU, part in row 1, column 1]

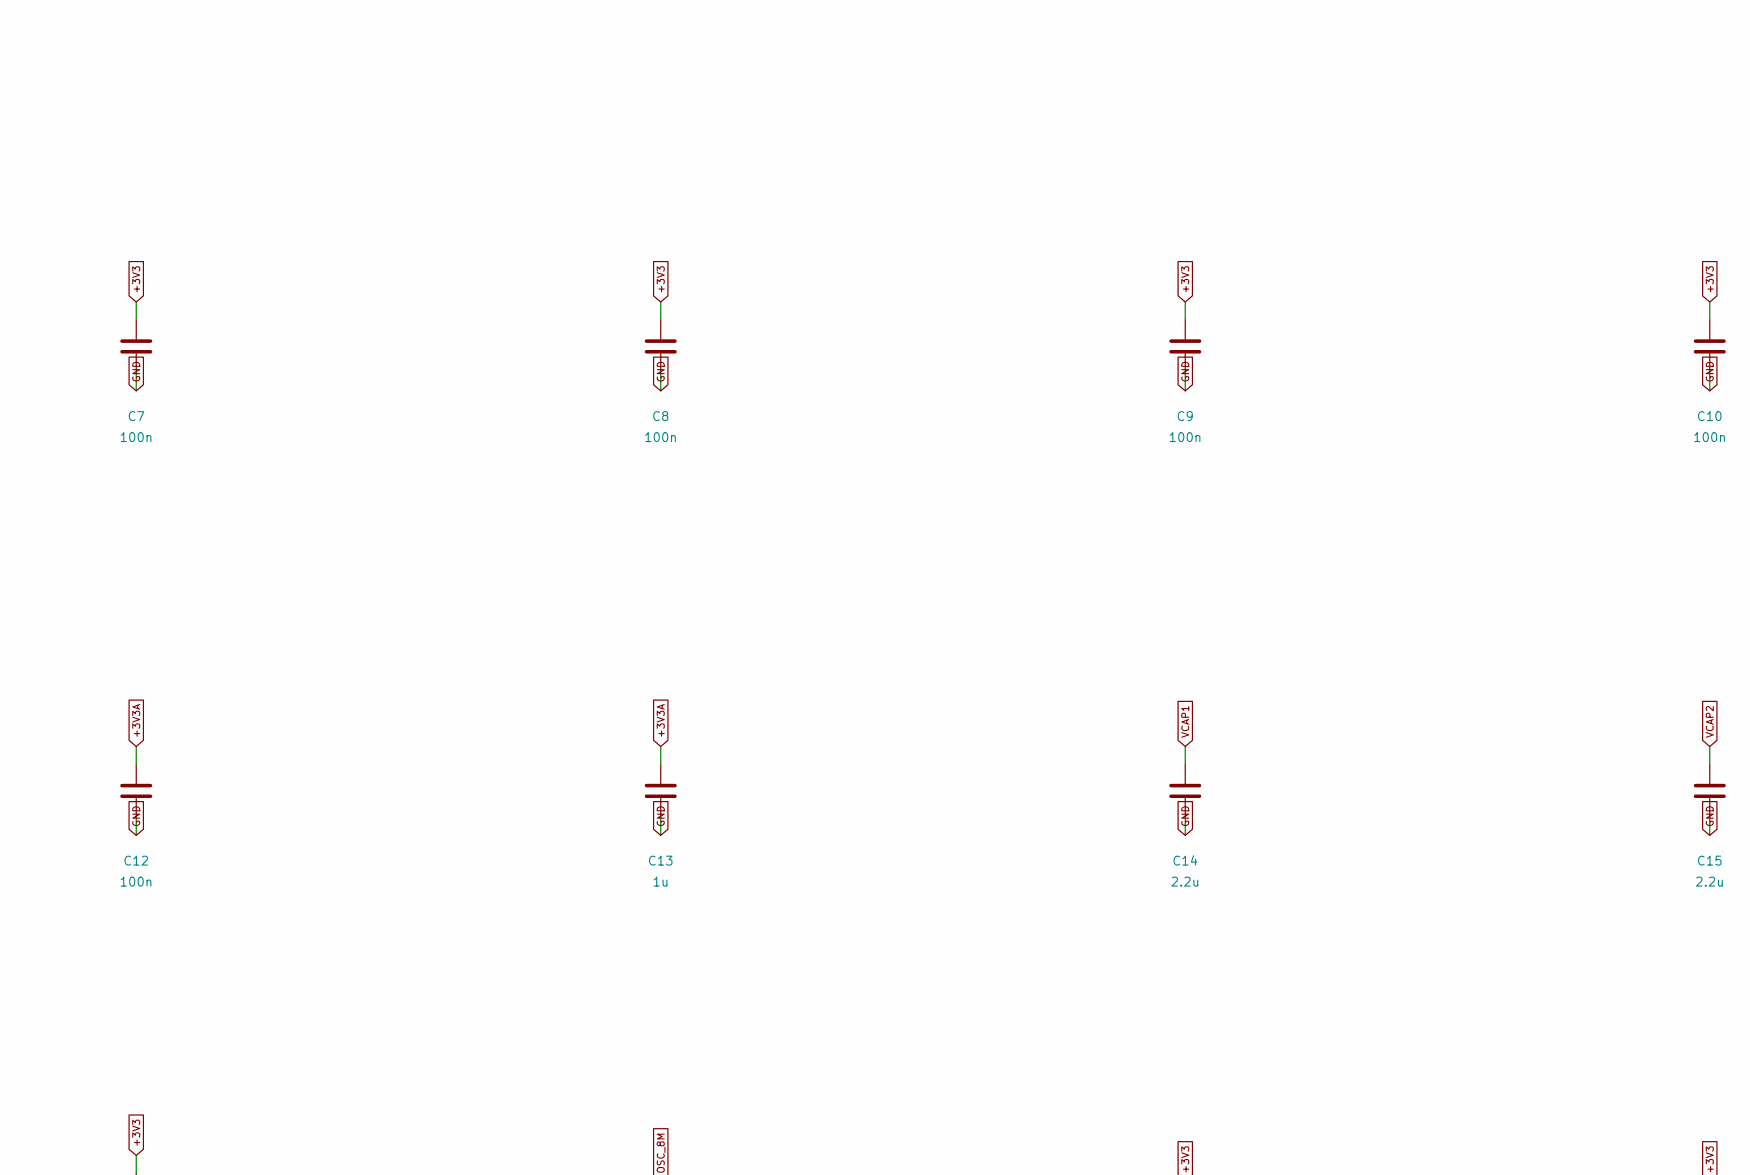
[picture p29: schematic mcu.kicad_sch, VOICE PITCHER — MCU, part in row 1, column 2]

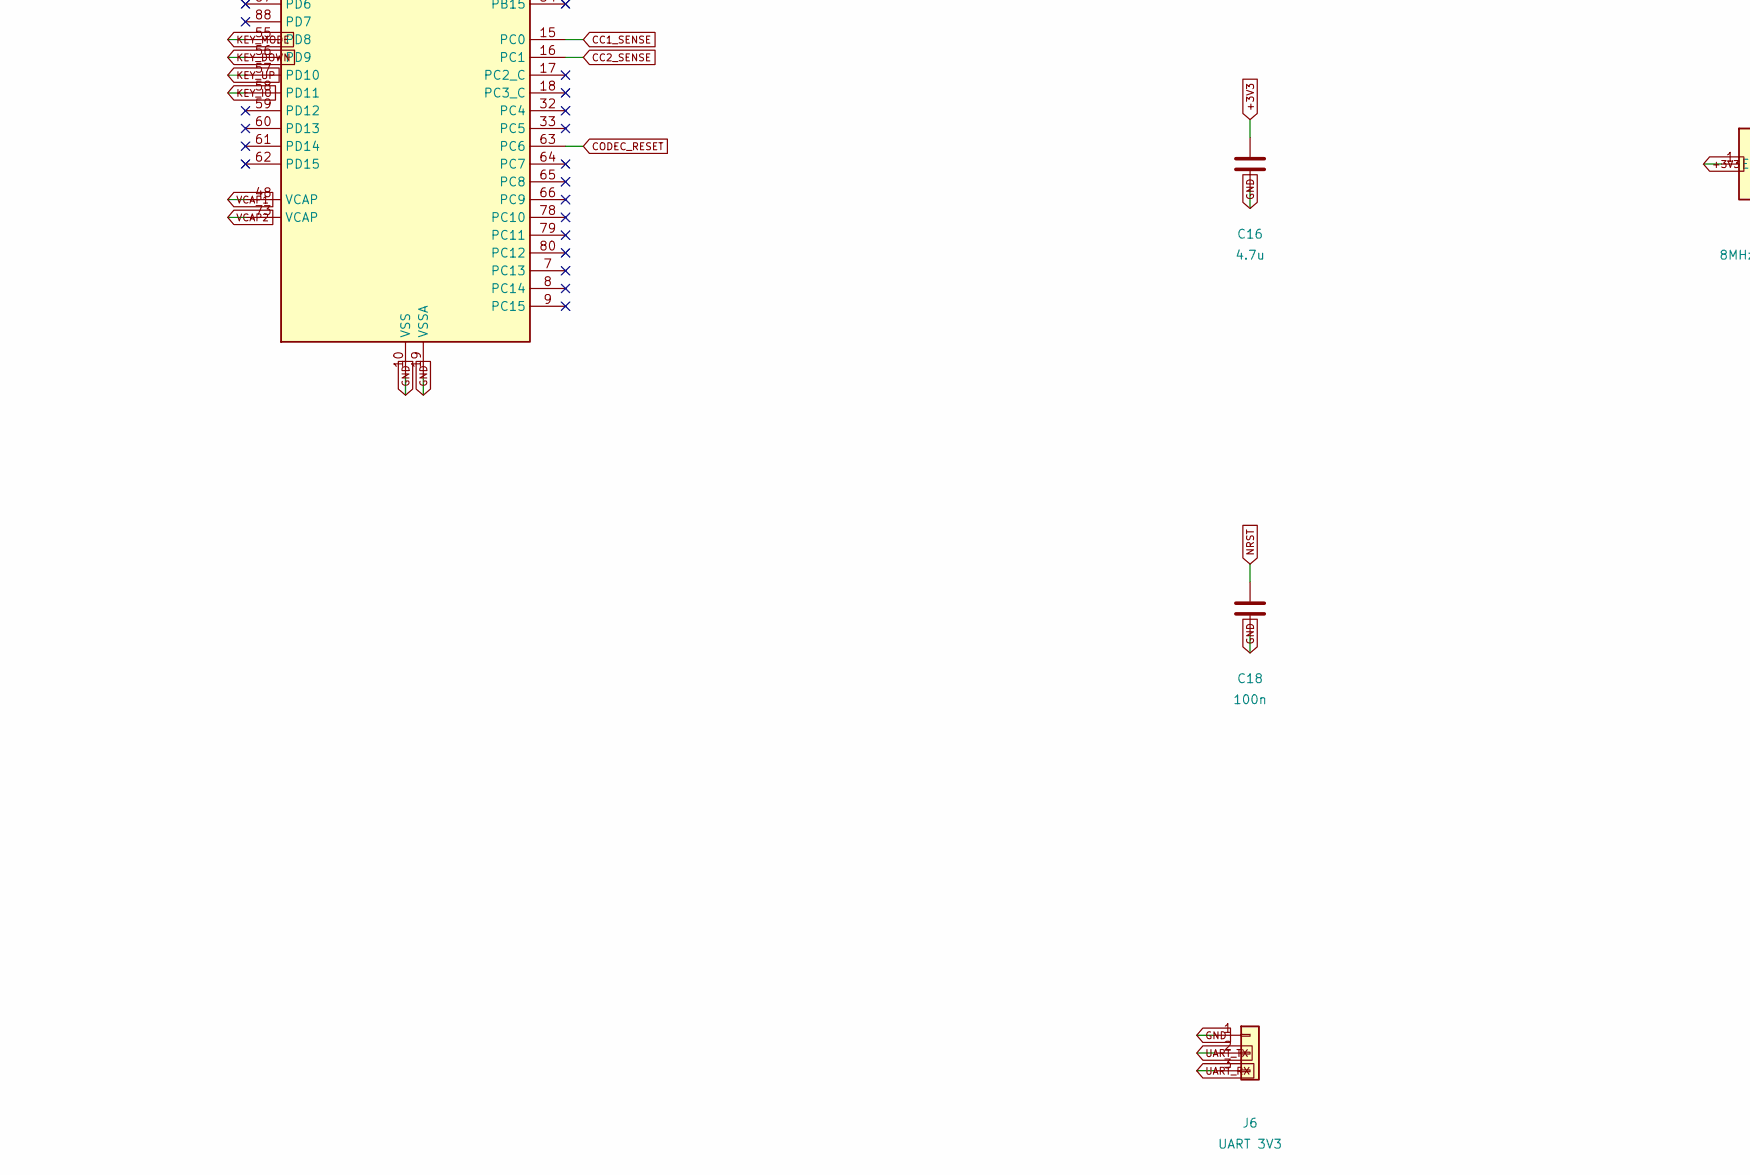
[picture p30: schematic mcu.kicad_sch, VOICE PITCHER — MCU, part in row 2, column 1]

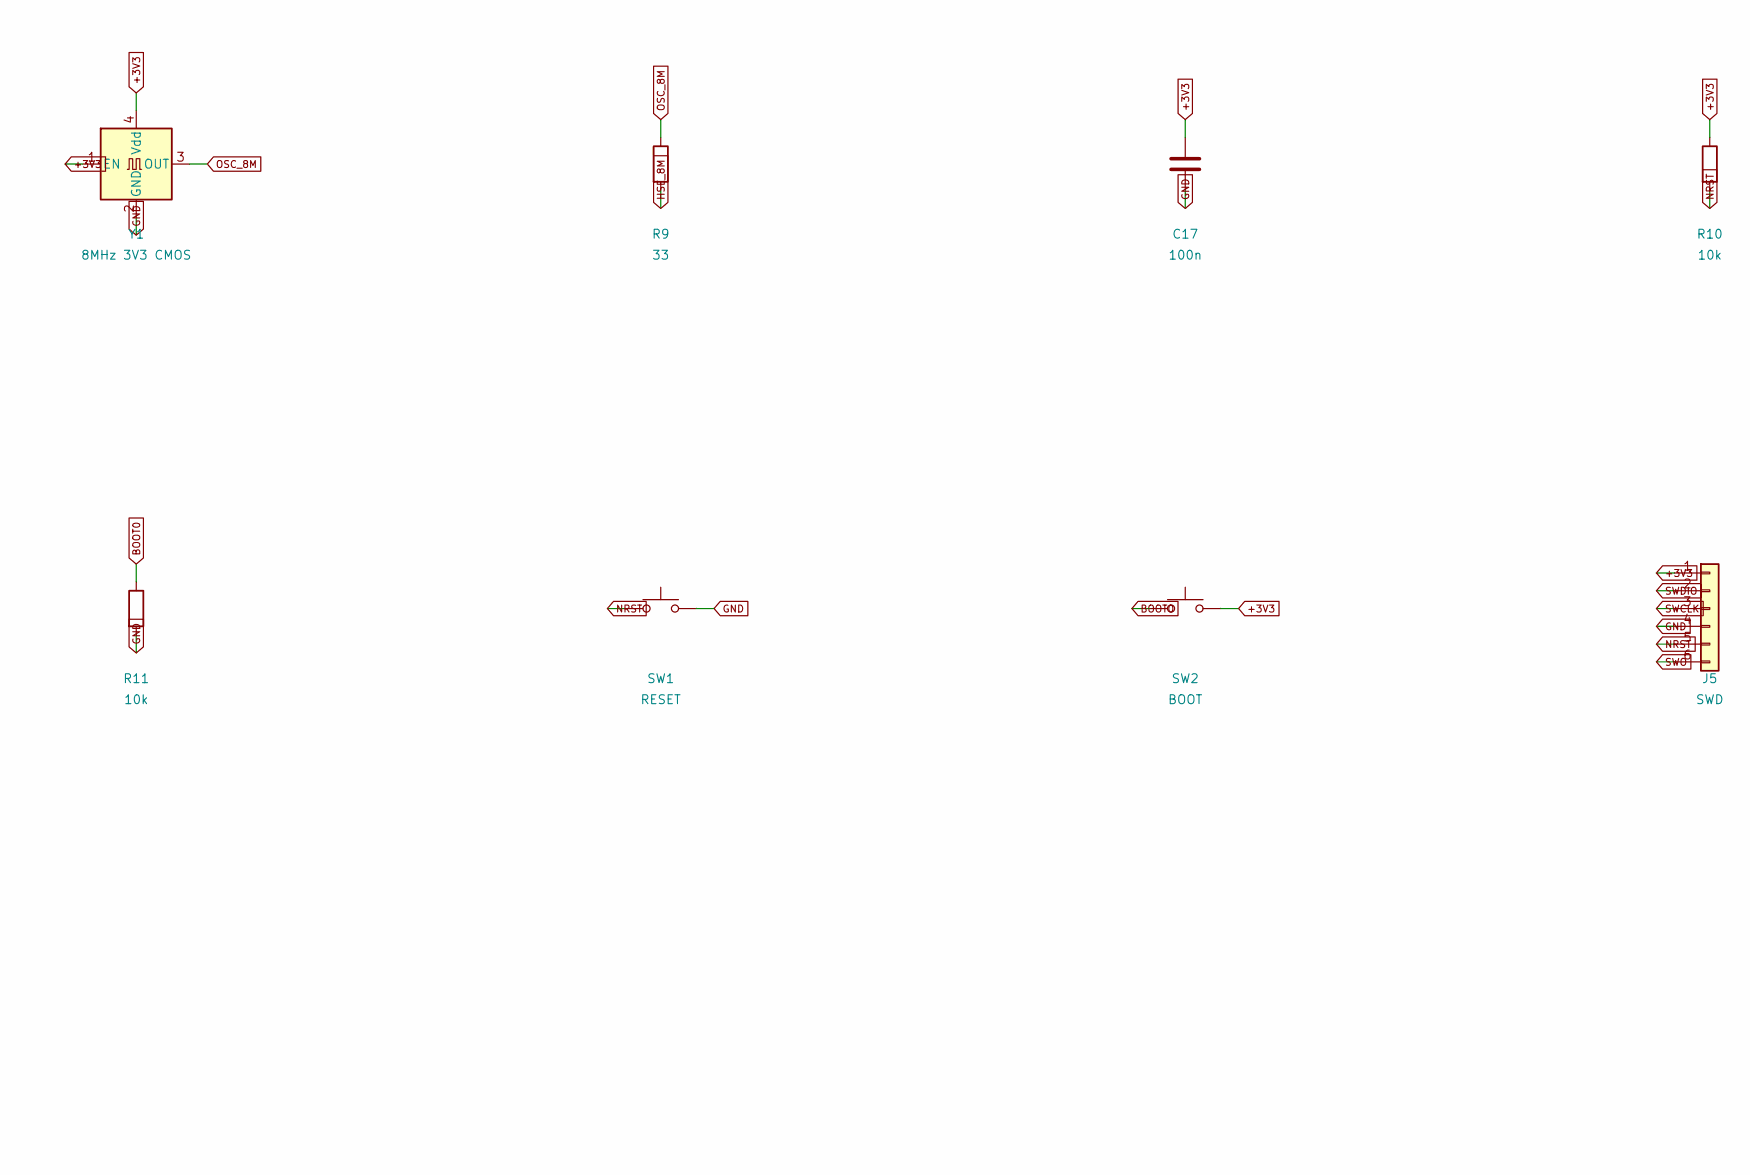
[picture p31: schematic mcu.kicad_sch, VOICE PITCHER — MCU, part in row 2, column 2]

Parts:
C7, C8, C9, C10, C11, C12, C17, C18: 100n; Capacitor_SMD__C_0603_1608Metric; MPN CC0603KRX7R9BB104; LCSC C14663
C13: 1u; Capacitor_SMD__C_0603_1608Metric; MPN GRM188R71C105KA12D
C14, C15: 2.2u; Capacitor_SMD__C_0603_1608Metric; MPN GRM188R61C225KE15D
C16: 4.7u; Capacitor_SMD__C_0603_1608Metric; MPN GRM188R61C475KE11D
FB2: 120R@100MHz; Inductor_SMD__L_0805_2012Metric; MPN BLM21PG121SN1D
J5: SWD; Connector_PinHeader_2.54mm__PinHeader_1x06_P2.54mm_Vertical; MPN 1x6 2.54mm header
J6: UART 3V3; Connector_PinHeader_2.54mm__PinHeader_1x03_P2.54mm_Vertical; MPN 1x3 2.54mm header
R9: 33; Resistor_SMD__R_0603_1608Metric; MPN 0603WAF330JT5E; LCSC C23140
R10, R11: 10k; Resistor_SMD__R_0603_1608Metric; MPN 0603WAF1002T5E; LCSC C25804
SW1: RESET; Button_Switch_SMD__SW_SPST_TL3342; MPN TL3342F160QG
SW2: BOOT; Button_Switch_SMD__SW_SPST_TL3342; MPN TL3342F160QG
U1: STM32H743VIT6; Package_QFP__LQFP-100_14x14mm_P0.5mm; MPN STM32H743VIT6; LCSC C114409
Y1: 8MHz 3V3 CMOS; Oscillator__Oscillator_SMD_Abracon_ASE-4Pin_3.2x2.5mm; MPN ASE-8.000MHZ-LC-T

Connections:
+3V3: C7.1, C8.1, C9.1, C10.1, C11.1, C16.1, C17.1, FB2.1, J5.1, R10.1, SW2.2, U1.6 (VBAT), U1.11 (VDD), U1.27 (VDD), U1.50 (VDD), U1.75 (VDD), U1.100 (VDD), Y1.1 (EN), Y1.4 (Vdd); also elsewhere on the board
+3V3A: C12.1, C13.1, FB2.2, U1.20 (VREF+), U1.21 (VDDA)
BOOT0: R11.1, SW2.1, U1.94 (BOOT0)
CC1_SENSE: U1.15 (PC0); also elsewhere on the board
CC2_SENSE: U1.16 (PC1); also elsewhere on the board
CODEC_RESET: U1.63 (PC6); also elsewhere on the board
GND: C7.2, C8.2, C9.2, C10.2, C11.2, C12.2, C13.2, C14.2, C15.2, C16.2, C17.2, C18.2, J5.4, J6.1, R11.2, SW1.2, U1.10 (VSS), U1.19 (VSSA), U1.26 (VSS), U1.49 (VSS), U1.74 (VSS), U1.99 (VSS), Y1.2 (GND); also elsewhere on the board
HSE_8M: R9.2, U1.12 (PH0)
I2C_SCL: U1.95 (PB8); also elsewhere on the board
I2C_SDA: U1.96 (PB9); also elsewhere on the board
KEY_DOWN: U1.56 (PD9); also elsewhere on the board
KEY_IO: U1.58 (PD11); also elsewhere on the board
KEY_MODE: U1.55 (PD8); also elsewhere on the board
KEY_UP: U1.57 (PD10); also elsewhere on the board
MCU_USB_DM: U1.70 (PA11); also elsewhere on the board
MCU_USB_DP: U1.71 (PA12); also elsewhere on the board
NRST: C18.1, J5.5, R10.2, SW1.1, U1.14 (NRST)
OSC_8M: R9.1, Y1.3 (OUT)
SAI_ADC: U1.2 (PE3); also elsewhere on the board
SAI_BCLK: U1.4 (PE5); also elsewhere on the board
SAI_DAC: U1.5 (PE6); also elsewhere on the board
SAI_LRCK: U1.3 (PE4); also elsewhere on the board
SAI_MCLK: U1.1 (PE2); also elsewhere on the board
STATUS_LED: U1.34 (PB0); also elsewhere on the board
SWCLK: J5.3, U1.76 (PA14)
SWDIO: J5.2, U1.72 (PA13)
SWO: J5.6, U1.89 (PB3)
UART_RX: J6.3, U1.47 (PB11)
UART_TX: J6.2, U1.46 (PB10)
VBUS_SENSE: U1.68 (PA9); also elsewhere on the board
VCAP1: C14.1, U1.48 (VCAP)
VCAP2: C15.1, U1.73 (VCAP)

Notes on the sheet:
All named nets are global. Unused pins are explicitly NC.
See docs/hardware.md for design assumptions and open validation items.

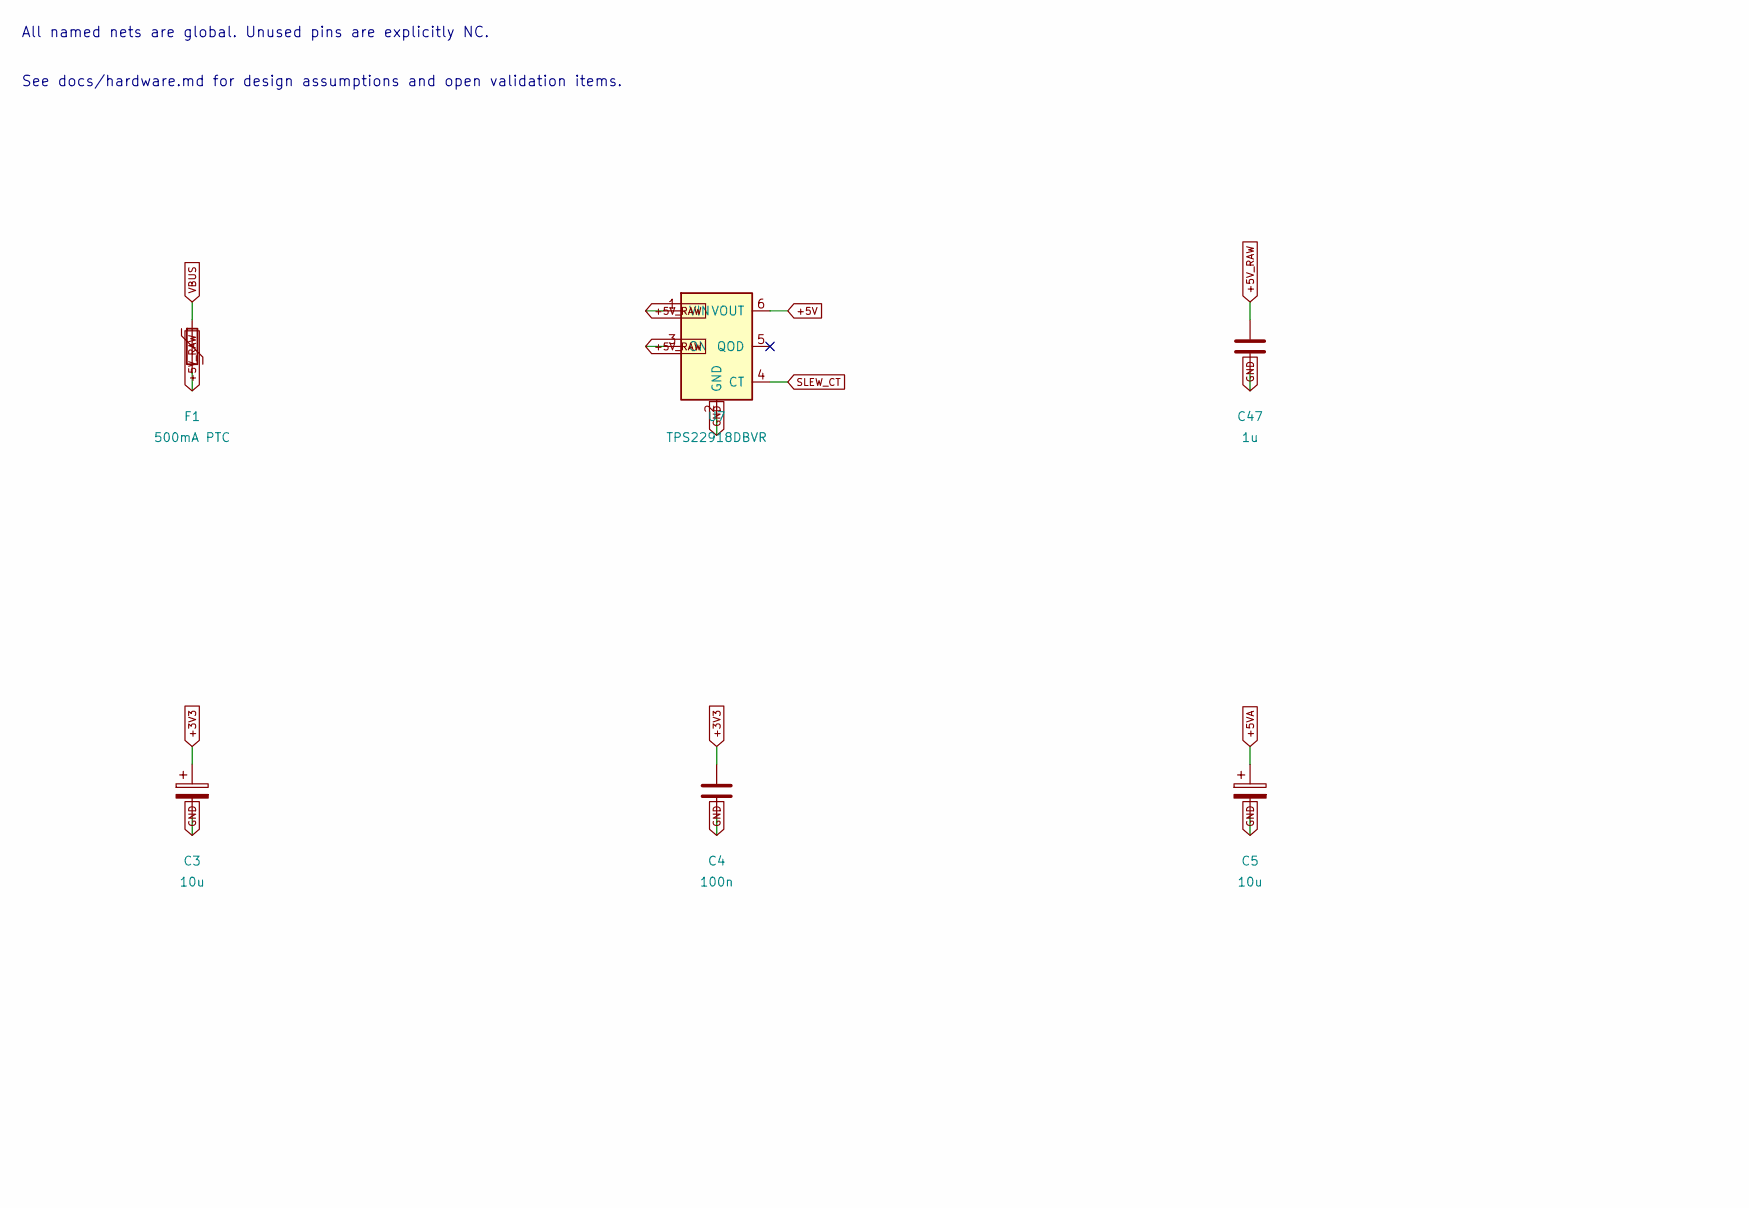
[picture p32: schematic power.kicad_sch, VOICE PITCHER — POWER, part in row 1, column 1]

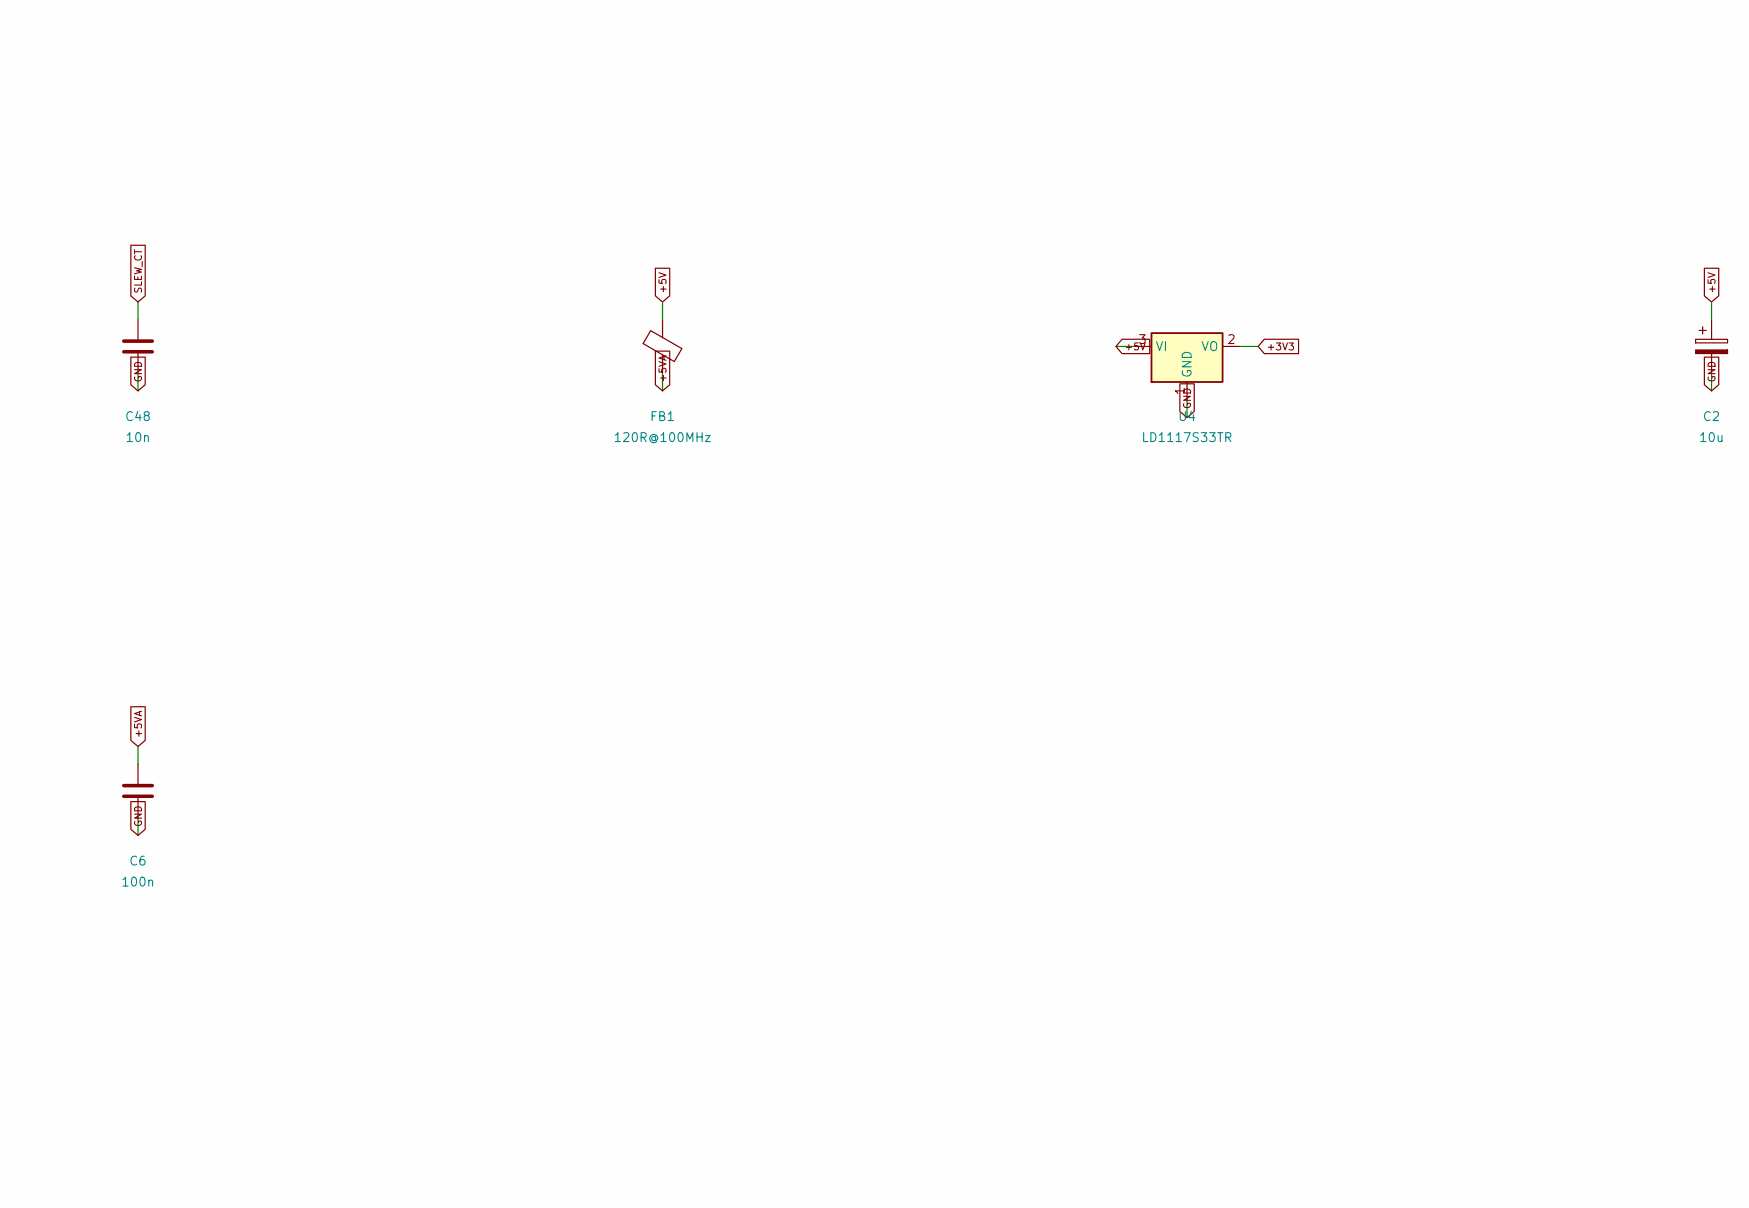
[picture p33: schematic power.kicad_sch, VOICE PITCHER — POWER, part in row 1, column 2]

Parts:
C2, C3, C5: 10u; Capacitor_SMD__CP_Elec_4x5.8; MPN UWT1C100MCL1GB
C4, C6: 100n; Capacitor_SMD__C_0603_1608Metric; MPN CC0603KRX7R9BB104; LCSC C14663
C47: 1u; Capacitor_SMD__C_0603_1608Metric; MPN GRM188R71C105KA12D
C48: 10n; Capacitor_SMD__C_0603_1608Metric; MPN GRM188R71E103KA01D
F1: 500mA PTC; Fuse__Fuse_1206_3216Metric; MPN 1206L050YR
FB1: 120R@100MHz; Inductor_SMD__L_0805_2012Metric; MPN BLM21PG121SN1D
U4: LD1117S33TR; Package_TO_SOT_SMD__SOT-223-3_TabPin2; MPN LD1117S33TR
U7: TPS22918DBVR; Package_TO_SOT_SMD__SOT-23-6; MPN TPS22918DBVR

Connections:
+3V3: C3.1, C4.1, U4.2 (VO); also elsewhere on the board
+5V: C2.1, FB1.1, U4.3 (VI), U7.6 (VOUT)
+5VA: C5.1, C6.1, FB1.2; also elsewhere on the board
+5V_RAW: C47.1, F1.2, U7.1 (VIN), U7.3 (ON)
GND: C2.2, C3.2, C4.2, C5.2, C6.2, C47.2, C48.2, U4.1 (GND), U7.2 (GND); also elsewhere on the board
SLEW_CT: C48.1, U7.4 (CT)
VBUS: F1.1; also elsewhere on the board

Notes on the sheet:
All named nets are global. Unused pins are explicitly NC.
See docs/hardware.md for design assumptions and open validation items.

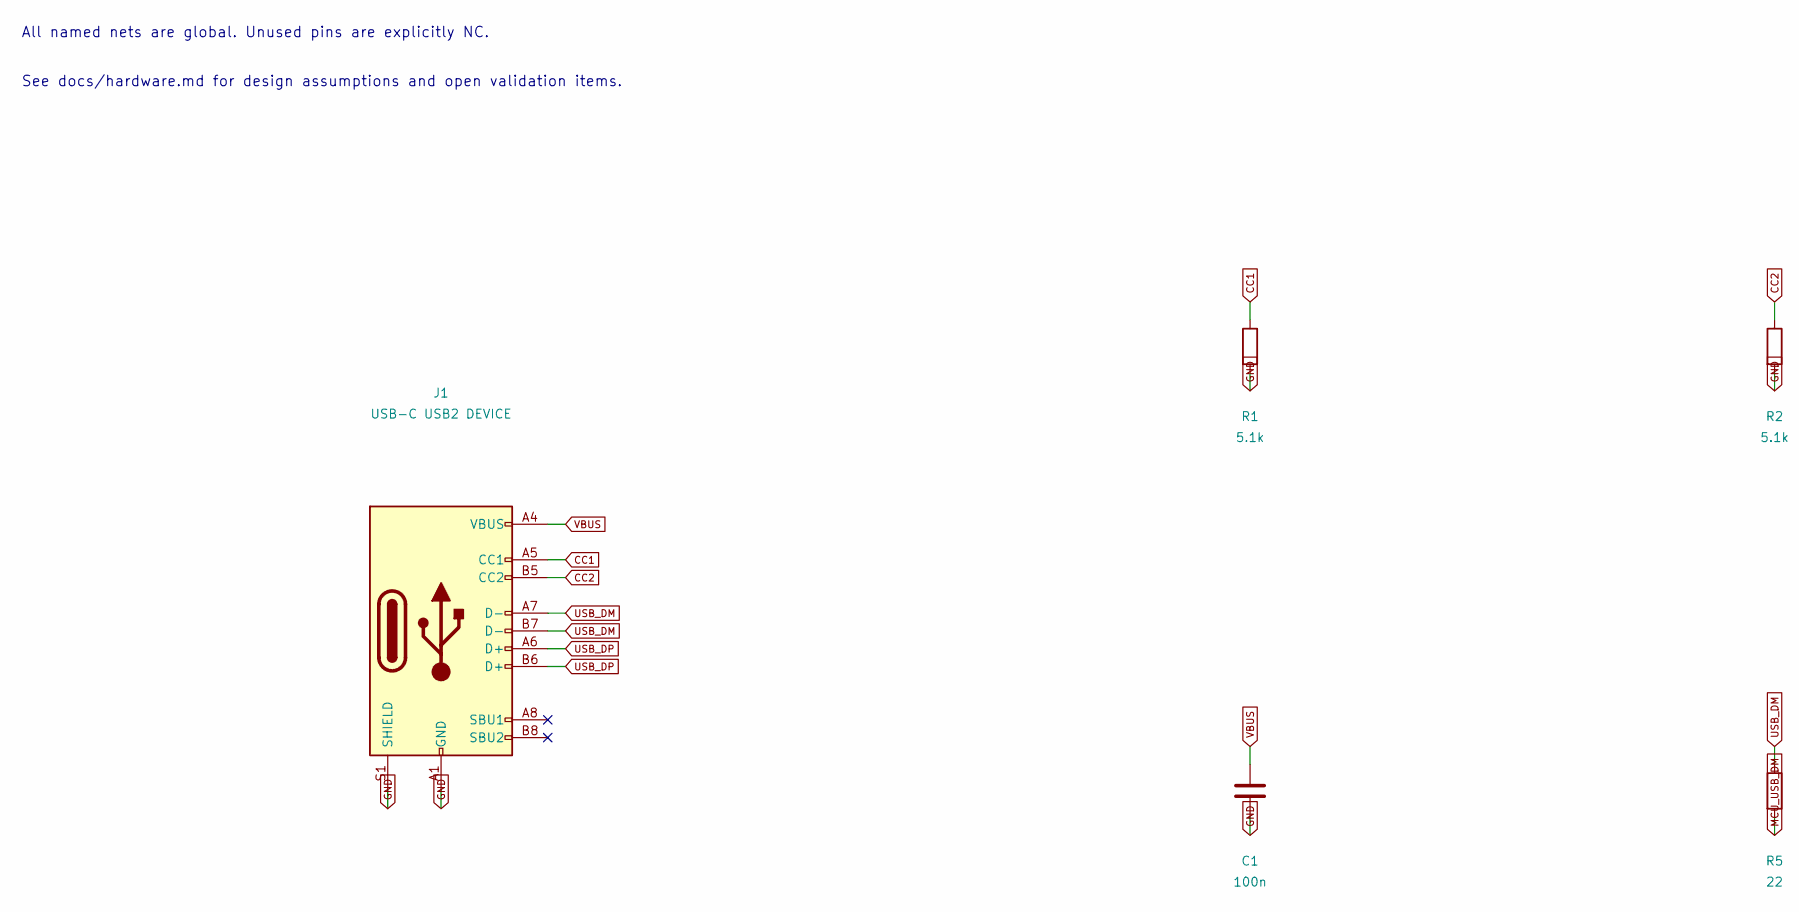
[picture p34: schematic usb.kicad_sch, VOICE PITCHER — USB, part in row 1, column 1]

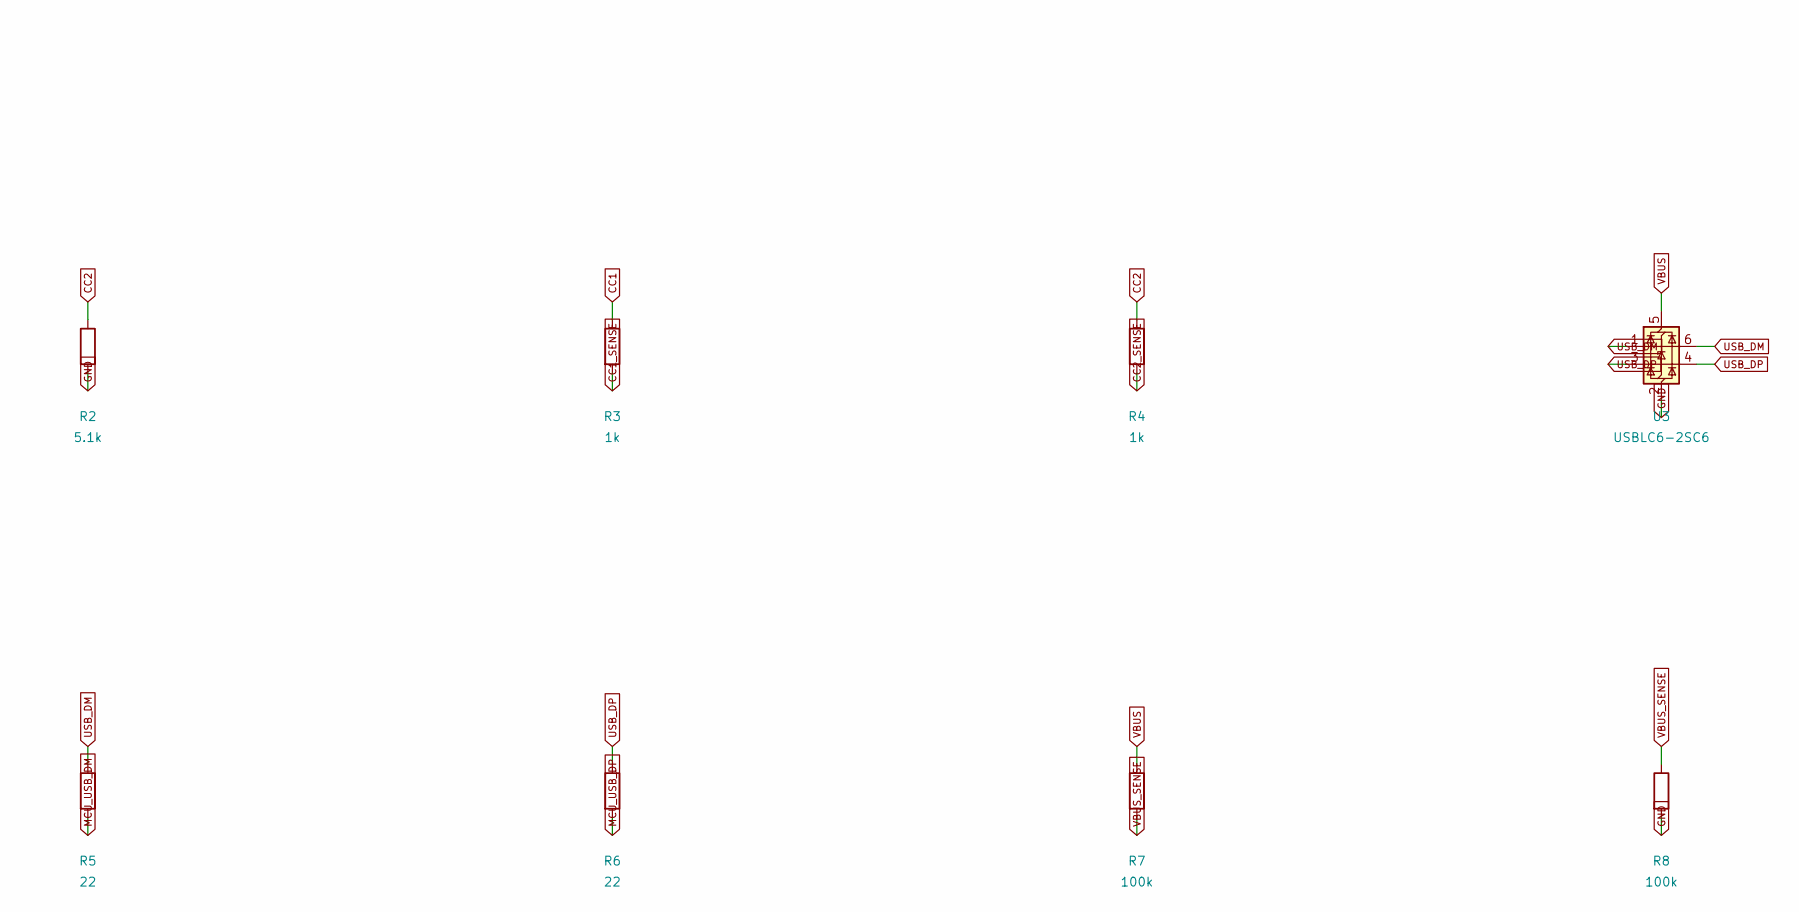
[picture p35: schematic usb.kicad_sch, VOICE PITCHER — USB, part in row 1, column 2]

Parts:
C1: 100n; Capacitor_SMD__C_0603_1608Metric; MPN CC0603KRX7R9BB104; LCSC C14663
J1: USB-C USB2 DEVICE; Connector_USB__USB_C_Receptacle_HRO_TYPE-C-31-M-12; MPN TYPE-C-31-M-12; LCSC C165948
R1, R2: 5.1k; Resistor_SMD__R_0603_1608Metric; MPN 0603WAF5101T5E; LCSC C23186
R3, R4: 1k; Resistor_SMD__R_0603_1608Metric; MPN 0603WAF1001T5E; LCSC C21190
R5, R6: 22; Resistor_SMD__R_0603_1608Metric; MPN 0603WAF220JT5E; LCSC C23345
R7, R8: 100k; Resistor_SMD__R_0603_1608Metric; MPN 0603WAF1003T5E; LCSC C25803
U3: USBLC6-2SC6; Package_TO_SOT_SMD__SOT-23-6; MPN USBLC6-2SC6; LCSC C7519

Connections:
CC1: J1.A5 (CC1), R1.1, R3.1
CC1_SENSE: R3.2; also elsewhere on the board
CC2: J1.B5 (CC2), R2.1, R4.1
CC2_SENSE: R4.2; also elsewhere on the board
GND: C1.2, J1.A1 (GND), J1.A12 (GND), J1.B1 (GND), J1.B12 (GND), J1.S1 (SHIELD), R1.2, R2.2, R8.2, U3.2 (GND); also elsewhere on the board
MCU_USB_DM: R5.2; also elsewhere on the board
MCU_USB_DP: R6.2; also elsewhere on the board
USB_DM: J1.A7 (D-), J1.B7 (D-), R5.1, U3.1 (I/O1), U3.6 (I/O1)
USB_DP: J1.A6 (D+), J1.B6 (D+), R6.1, U3.3 (I/O2), U3.4 (I/O2)
VBUS: C1.1, J1.A4 (VBUS), J1.A9 (VBUS), J1.B4 (VBUS), J1.B9 (VBUS), R7.1, U3.5 (VBUS); also elsewhere on the board
VBUS_SENSE: R7.2, R8.1; also elsewhere on the board

Notes on the sheet:
All named nets are global. Unused pins are explicitly NC.
See docs/hardware.md for design assumptions and open validation items.
