Xenoah/pcb_voice-pitcher/hardware/voice_pitcher.kicad_pcb

## KiCad design hardware/voice_pitcher.kicad_pcb (continued)

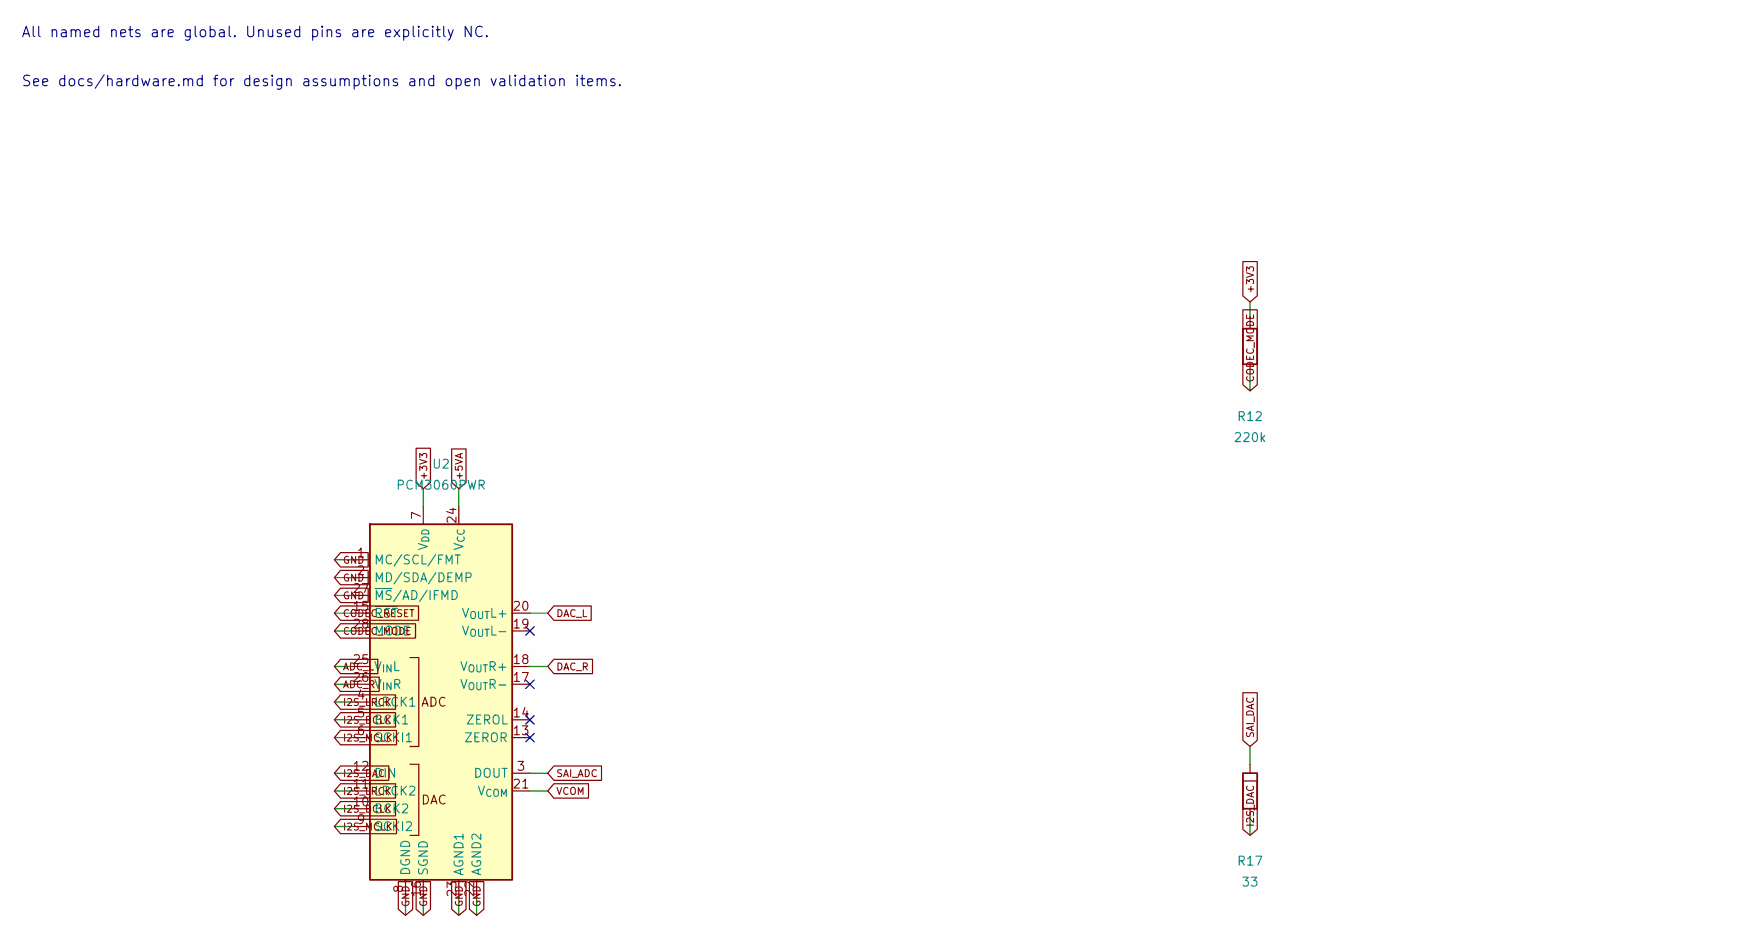
[picture p36: schematic codec.kicad_sch, VOICE PITCHER — CODEC, part in row 1, column 1]

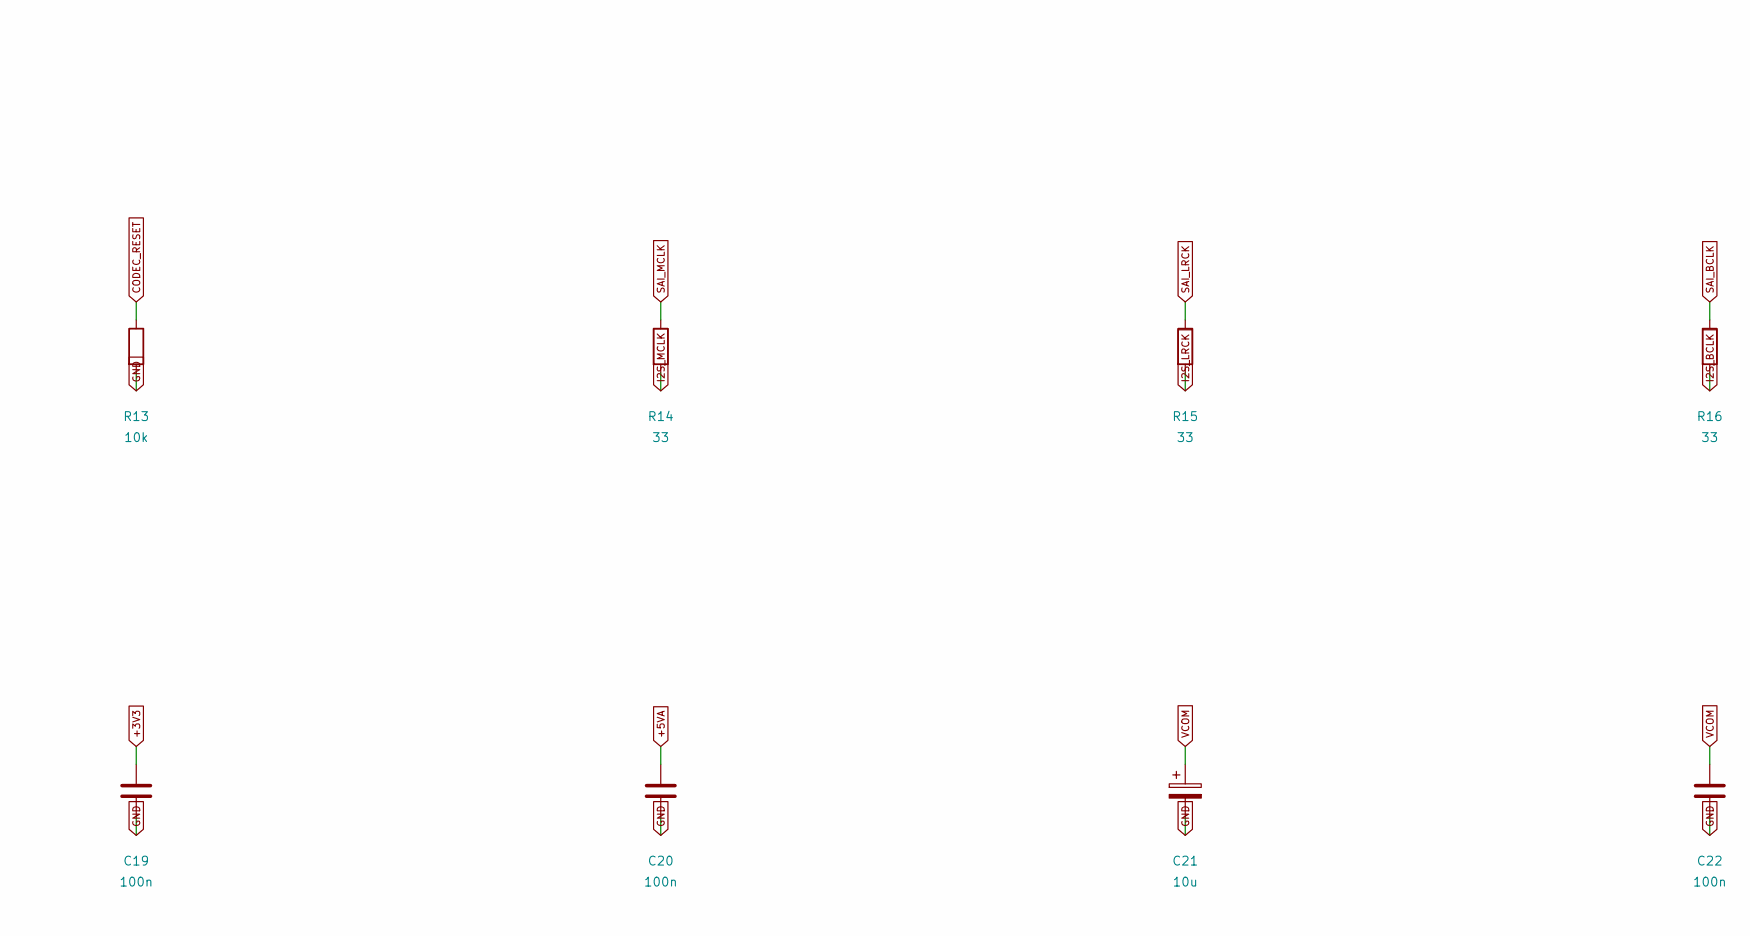
[picture p37: schematic codec.kicad_sch, VOICE PITCHER — CODEC, part in row 1, column 2]

Parts:
C19, C20, C22: 100n; Capacitor_SMD__C_0603_1608Metric; MPN CC0603KRX7R9BB104; LCSC C14663
C21: 10u; Capacitor_SMD__CP_Elec_4x5.8; MPN UWT1C100MCL1GB
R12: 220k; Resistor_SMD__R_0603_1608Metric; MPN 0603WAF2203T5E; LCSC C22961
R13: 10k; Resistor_SMD__R_0603_1608Metric; MPN 0603WAF1002T5E; LCSC C25804
R14, R15, R16, R17: 33; Resistor_SMD__R_0603_1608Metric; MPN 0603WAF330JT5E; LCSC C23140
U2: PCM3060PWR; Package_SO__TSSOP-28_4.4x9.7mm_P0.65mm; MPN PCM3060PWR; LCSC C2651841

Connections:
+3V3: C19.1, R12.1, U2.7 (V_{DD}); also elsewhere on the board
+5VA: C20.1, U2.24 (V_{CC}); also elsewhere on the board
ADC_L: U2.25 (V_{IN}L); also elsewhere on the board
ADC_R: U2.26 (V_{IN}R); also elsewhere on the board
CODEC_MODE: R12.2, U2.28 (MODE)
CODEC_RESET: R13.1, U2.15 (~RST); also elsewhere on the board
DAC_L: U2.20 (V_{OUT}L+); also elsewhere on the board
DAC_R: U2.18 (V_{OUT}R+); also elsewhere on the board
GND: C19.2, C20.2, C21.2, C22.2, R13.2, U2.1 (MC/SCL/FMT), U2.2 (MD/SDA/DEMP), U2.8 (DGND), U2.16 (SGND), U2.22 (AGND2), U2.23 (AGND1), U2.27 (~MS/AD/IFMD); also elsewhere on the board
I2S_BCLK: R16.2, U2.5 (BCK1), U2.10 (BCK2)
I2S_DAC: R17.2, U2.12 (DIN)
I2S_LRCK: R15.2, U2.4 (LRCK1), U2.11 (LRCK2)
I2S_MCLK: R14.2, U2.6 (SCKI1), U2.9 (SCKI2)
SAI_ADC: U2.3 (DOUT); also elsewhere on the board
SAI_BCLK: R16.1; also elsewhere on the board
SAI_DAC: R17.1; also elsewhere on the board
SAI_LRCK: R15.1; also elsewhere on the board
SAI_MCLK: R14.1; also elsewhere on the board
VCOM: C21.1, C22.1, U2.21 (V_{COM}); also elsewhere on the board

Notes on the sheet:
All named nets are global. Unused pins are explicitly NC.
See docs/hardware.md for design assumptions and open validation items.

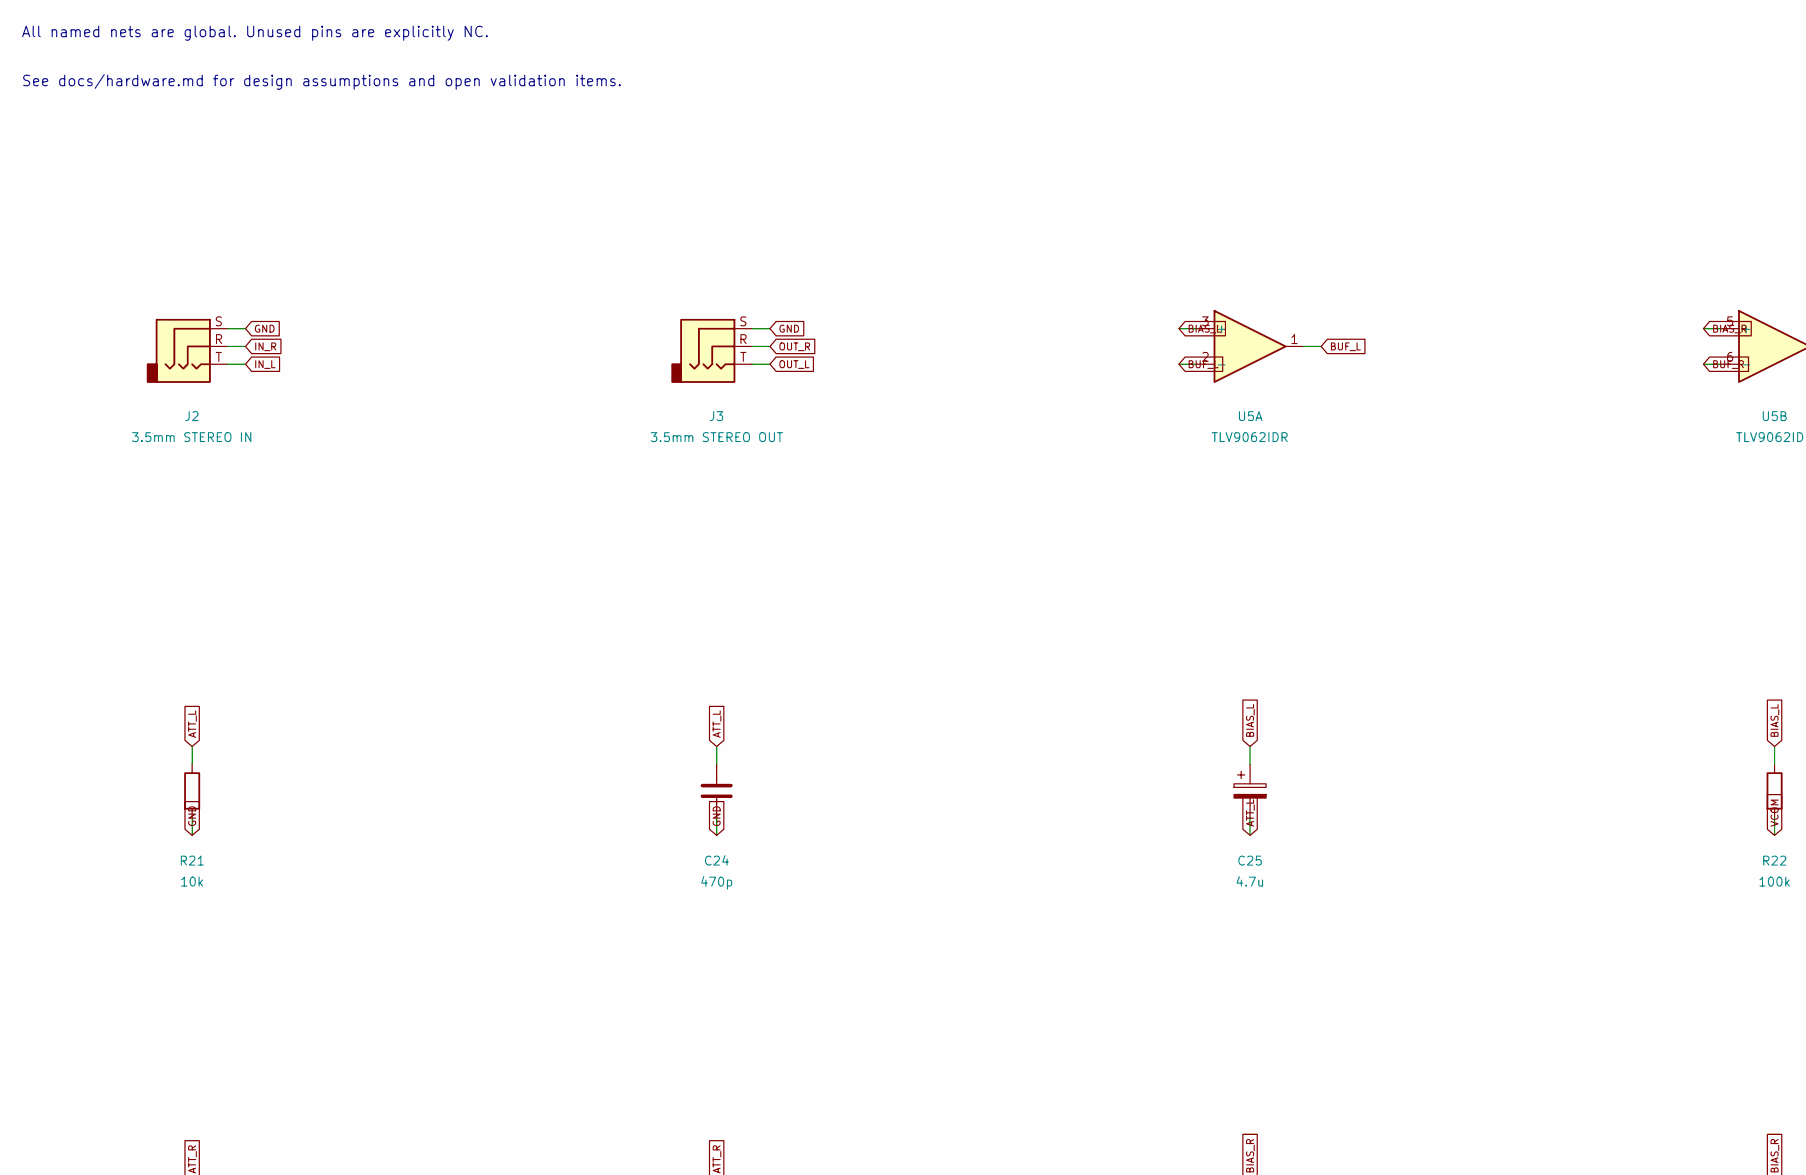
[picture p38: schematic analog.kicad_sch, VOICE PITCHER — ANALOG, part in row 1, column 1]

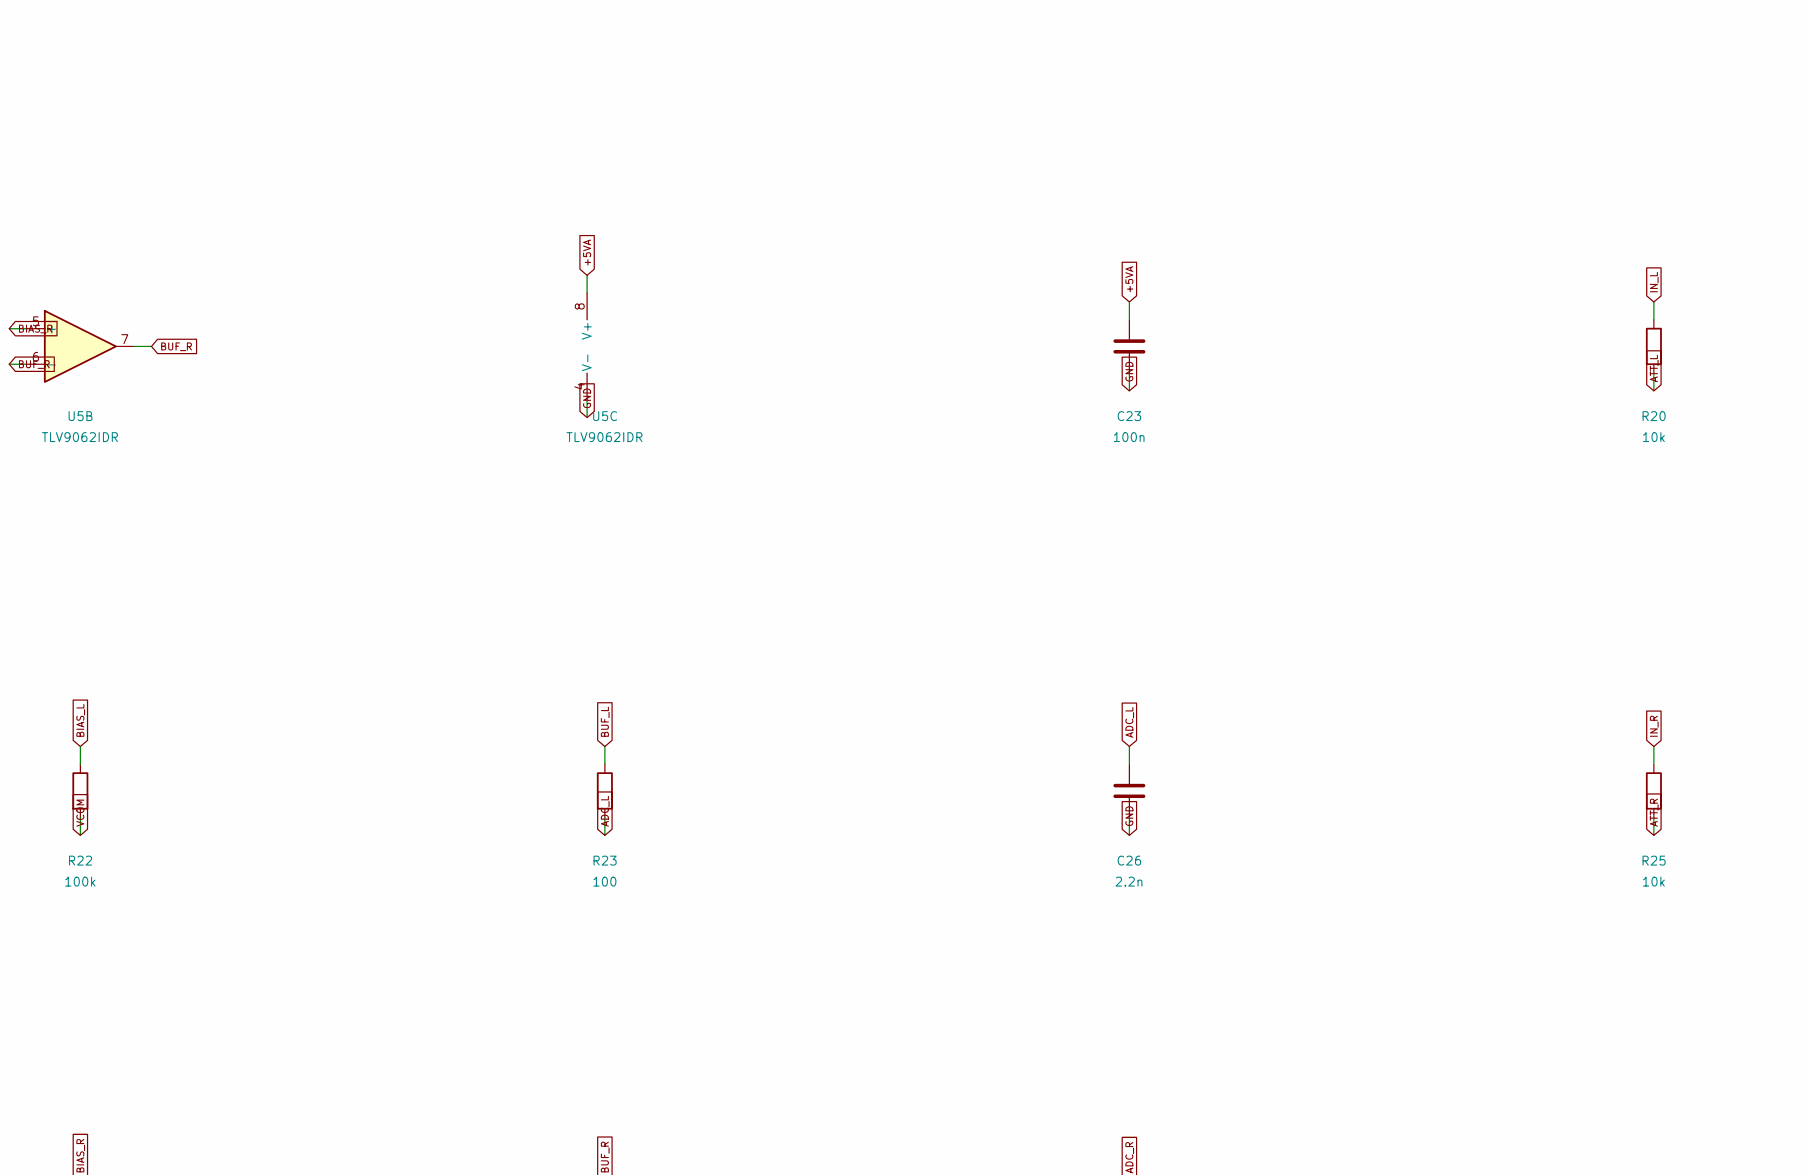
[picture p39: schematic analog.kicad_sch, VOICE PITCHER — ANALOG, part in row 1, column 2]

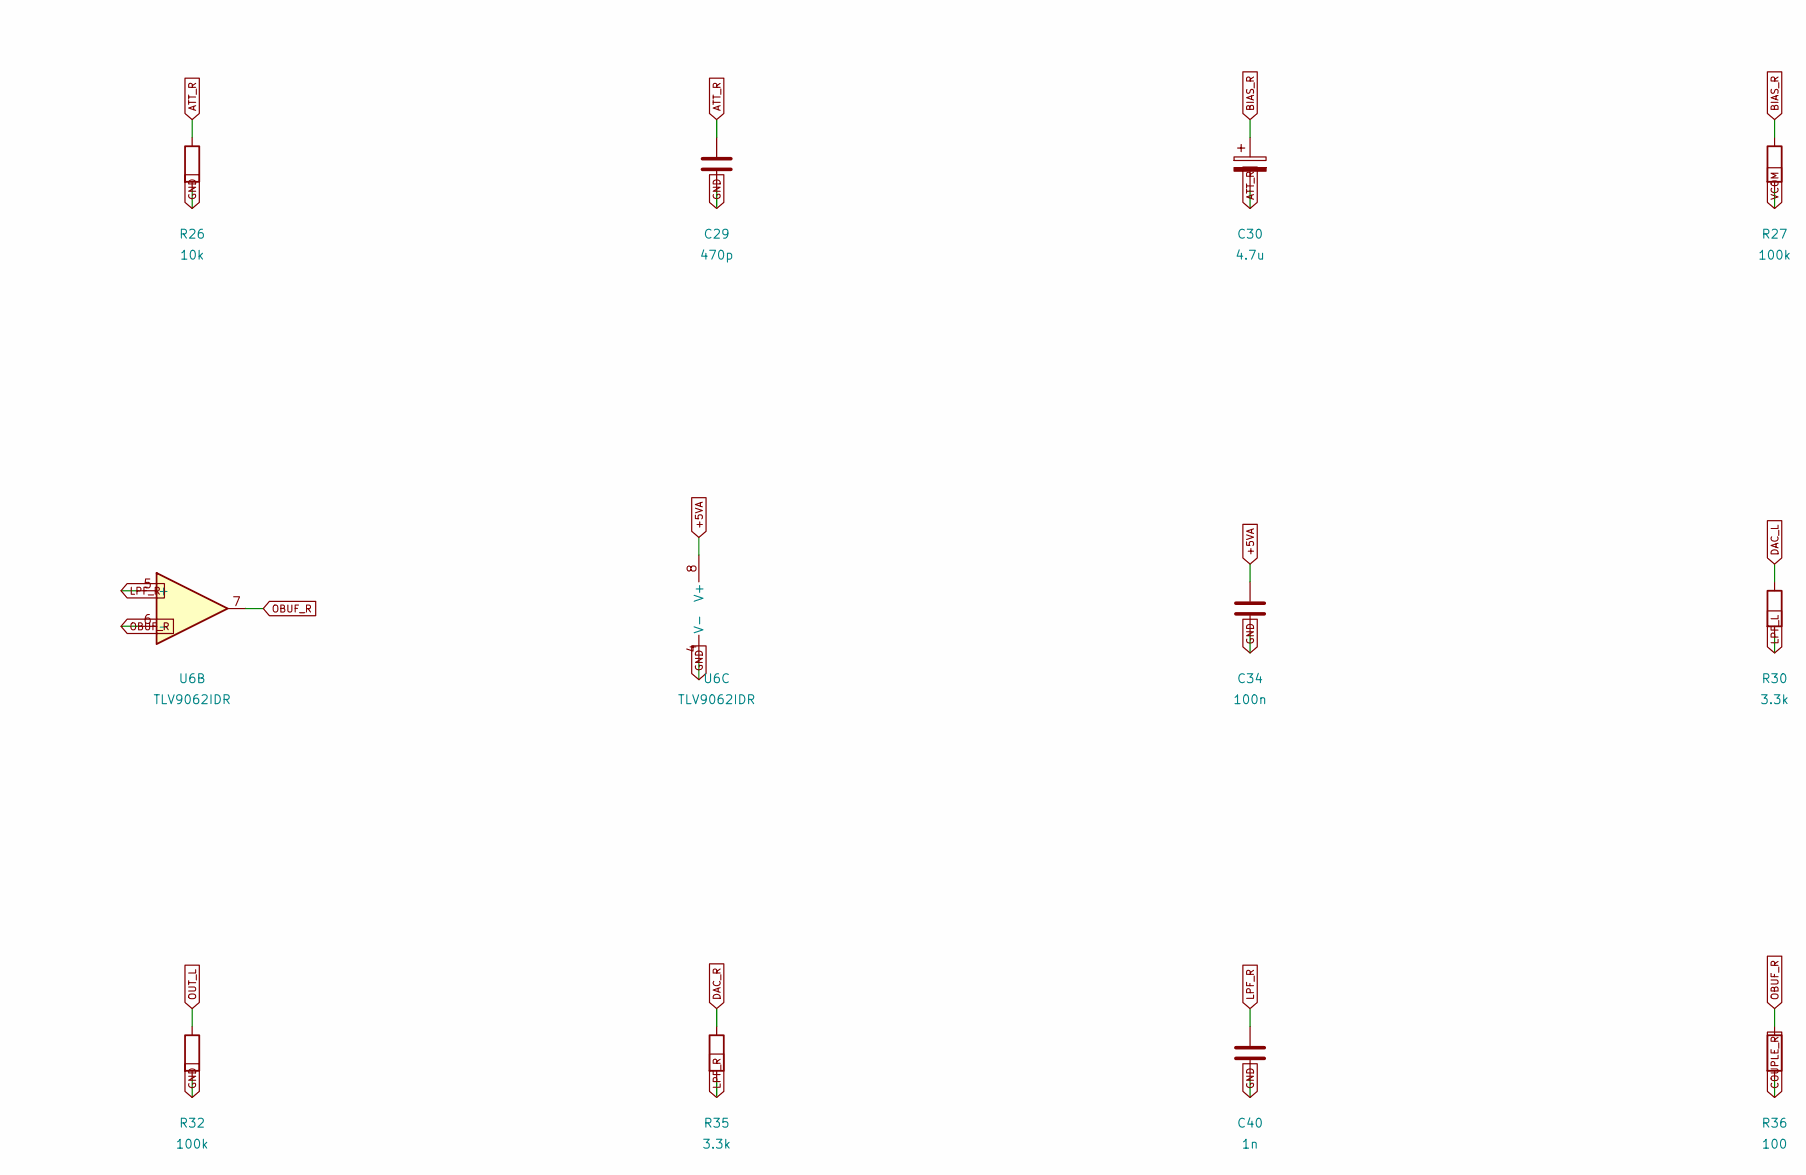
[picture p40: schematic analog.kicad_sch, VOICE PITCHER — ANALOG, part in row 2, column 1]

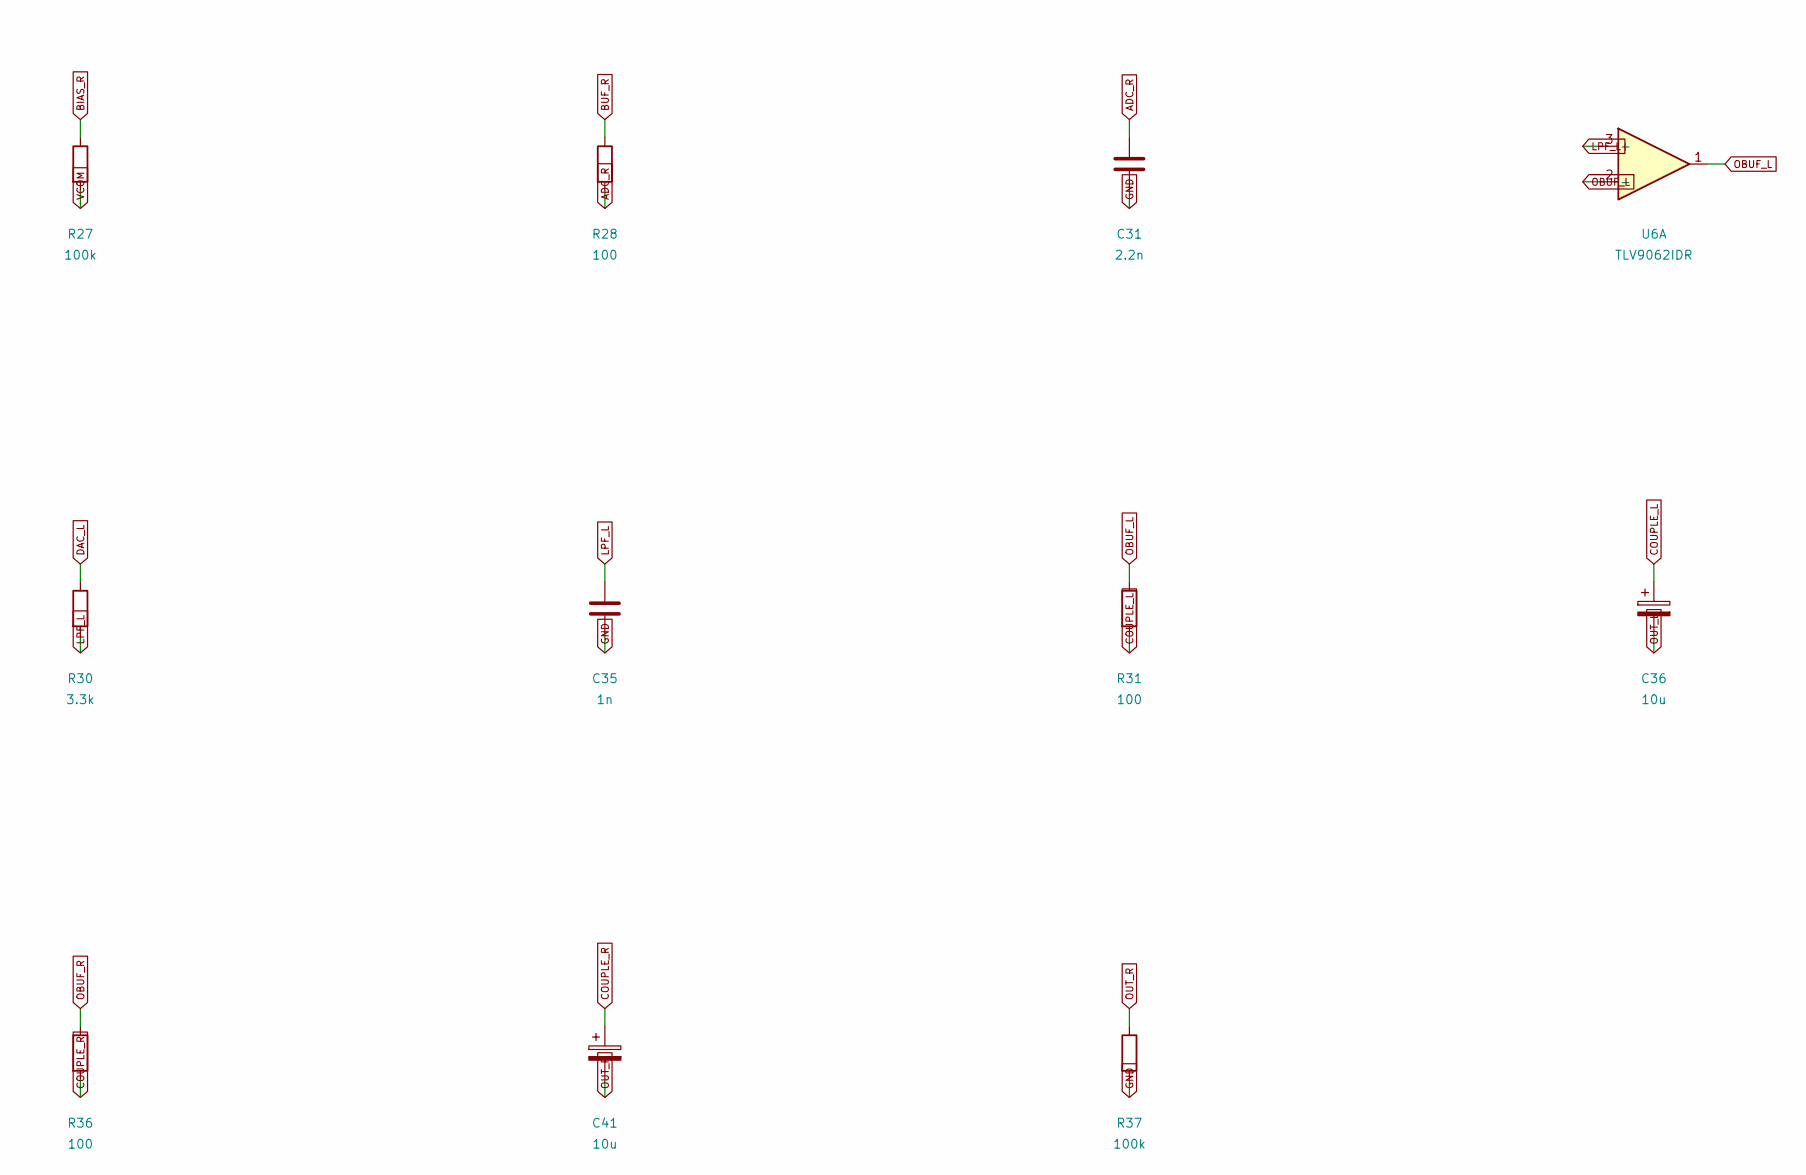
[picture p41: schematic analog.kicad_sch, VOICE PITCHER — ANALOG, part in row 2, column 2]

Parts:
C23, C34: 100n; Capacitor_SMD__C_0603_1608Metric; MPN CC0603KRX7R9BB104; LCSC C14663
C24, C29: 470p; Capacitor_SMD__C_0603_1608Metric; MPN GRM1885C1H471JA01D
C25, C30: 4.7u; Capacitor_SMD__CP_Elec_4x5.8; MPN UWT1C4R7MCL1GB
C26, C31: 2.2n; Capacitor_SMD__C_0603_1608Metric; MPN GRM1885C1H222JA01D
C35, C40: 1n; Capacitor_SMD__C_0603_1608Metric; MPN GRM1885C1H102JA01D
C36, C41: 10u; Capacitor_SMD__CP_Elec_4x5.8; MPN UWT1C100MCL1GB
J2: 3.5mm STEREO IN; Connector_Audio__Jack_3.5mm_CUI_SJ-3523-SMT_Horizontal; MPN SJ-3523-SMT-TR
J3: 3.5mm STEREO OUT; Connector_Audio__Jack_3.5mm_CUI_SJ-3523-SMT_Horizontal; MPN SJ-3523-SMT-TR
R20, R21, R25, R26: 10k; Resistor_SMD__R_0603_1608Metric; MPN 0603WAF1002T5E; LCSC C25804
R22, R27, R32, R37: 100k; Resistor_SMD__R_0603_1608Metric; MPN 0603WAF1003T5E; LCSC C25803
R23, R28, R31, R36: 100; Resistor_SMD__R_0603_1608Metric; MPN 0603WAF1000T5E; LCSC C22775
R30, R35: 3.3k; Resistor_SMD__R_0603_1608Metric; MPN 0603WAF3301T5E; LCSC C22978
U5, U6: TLV9062IDR; Package_SO__SOIC-8_3.9x4.9mm_P1.27mm; MPN TLV9062IDR

Connections:
+5VA: C23.1, C34.1, U5.8 (V+), U6.8 (V+); also elsewhere on the board
ADC_L: C26.1, R23.2; also elsewhere on the board
ADC_R: C31.1, R28.2; also elsewhere on the board
ATT_L: C24.1, C25.2, R20.2, R21.1
ATT_R: C29.1, C30.2, R25.2, R26.1
BIAS_L: C25.1, R22.1, U5.3 (+)
BIAS_R: C30.1, R27.1, U5.5 (+)
BUF_L: R23.1, U5.1, U5.2 (-)
BUF_R: R28.1, U5.6 (-), U5.7
COUPLE_L: C36.1, R31.2
COUPLE_R: C41.1, R36.2
DAC_L: R30.1; also elsewhere on the board
DAC_R: R35.1; also elsewhere on the board
GND: C23.2, C24.2, C26.2, C29.2, C31.2, C34.2, C35.2, C40.2, J2.S, J3.S, R21.2, R26.2, R32.2, R37.2, U5.4 (V-), U6.4 (V-); also elsewhere on the board
IN_L: J2.T, R20.1
IN_R: J2.R, R25.1
LPF_L: C35.1, R30.2, U6.3 (+)
LPF_R: C40.1, R35.2, U6.5 (+)
OBUF_L: R31.1, U6.1, U6.2 (-)
OBUF_R: R36.1, U6.6 (-), U6.7
OUT_L: C36.2, J3.T, R32.1
OUT_R: C41.2, J3.R, R37.1
VCOM: R22.2, R27.2; also elsewhere on the board

Notes on the sheet:
All named nets are global. Unused pins are explicitly NC.
See docs/hardware.md for design assumptions and open validation items.

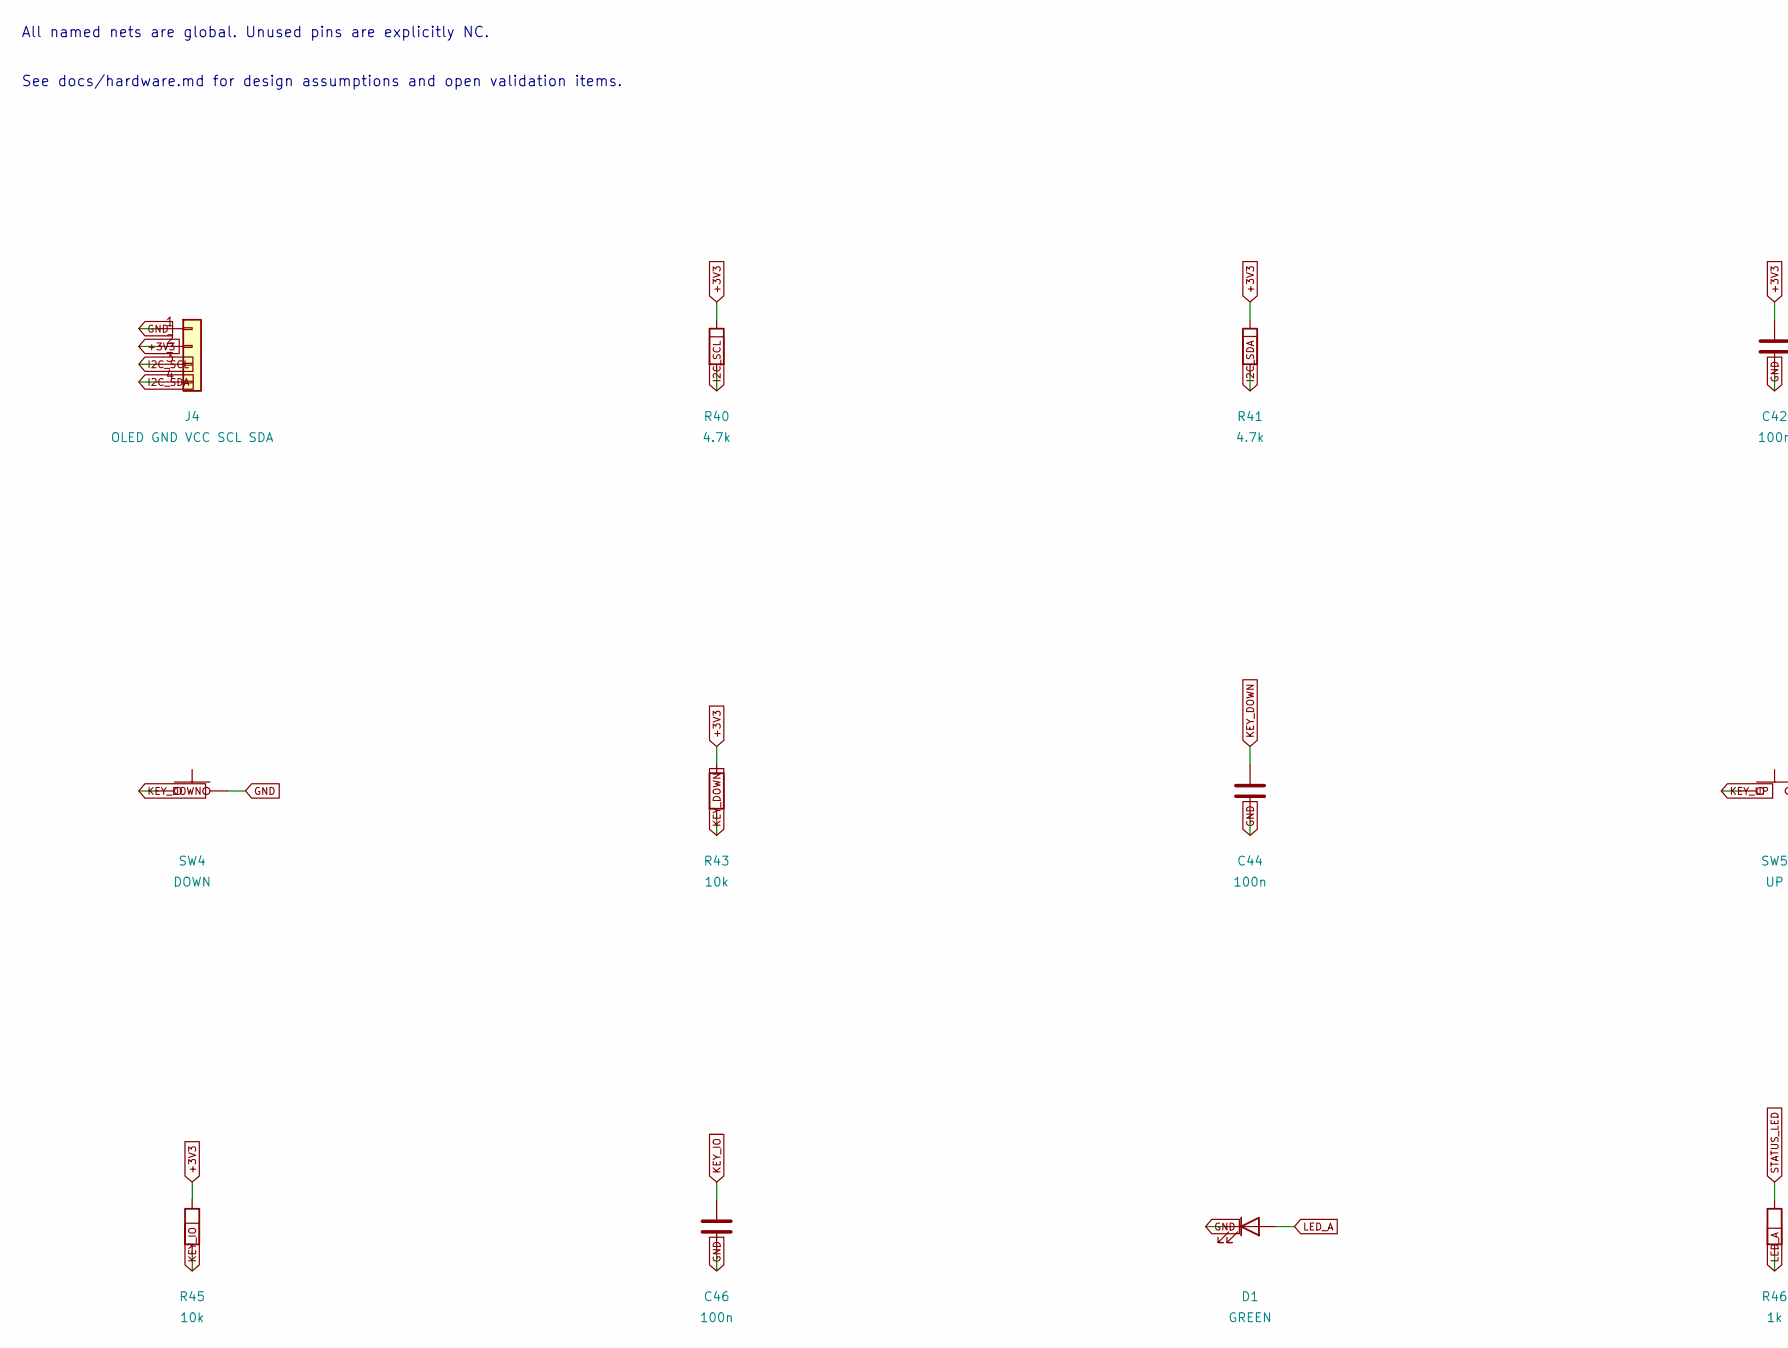
[picture p42: schematic ui.kicad_sch, VOICE PITCHER — UI, part in row 1, column 1]

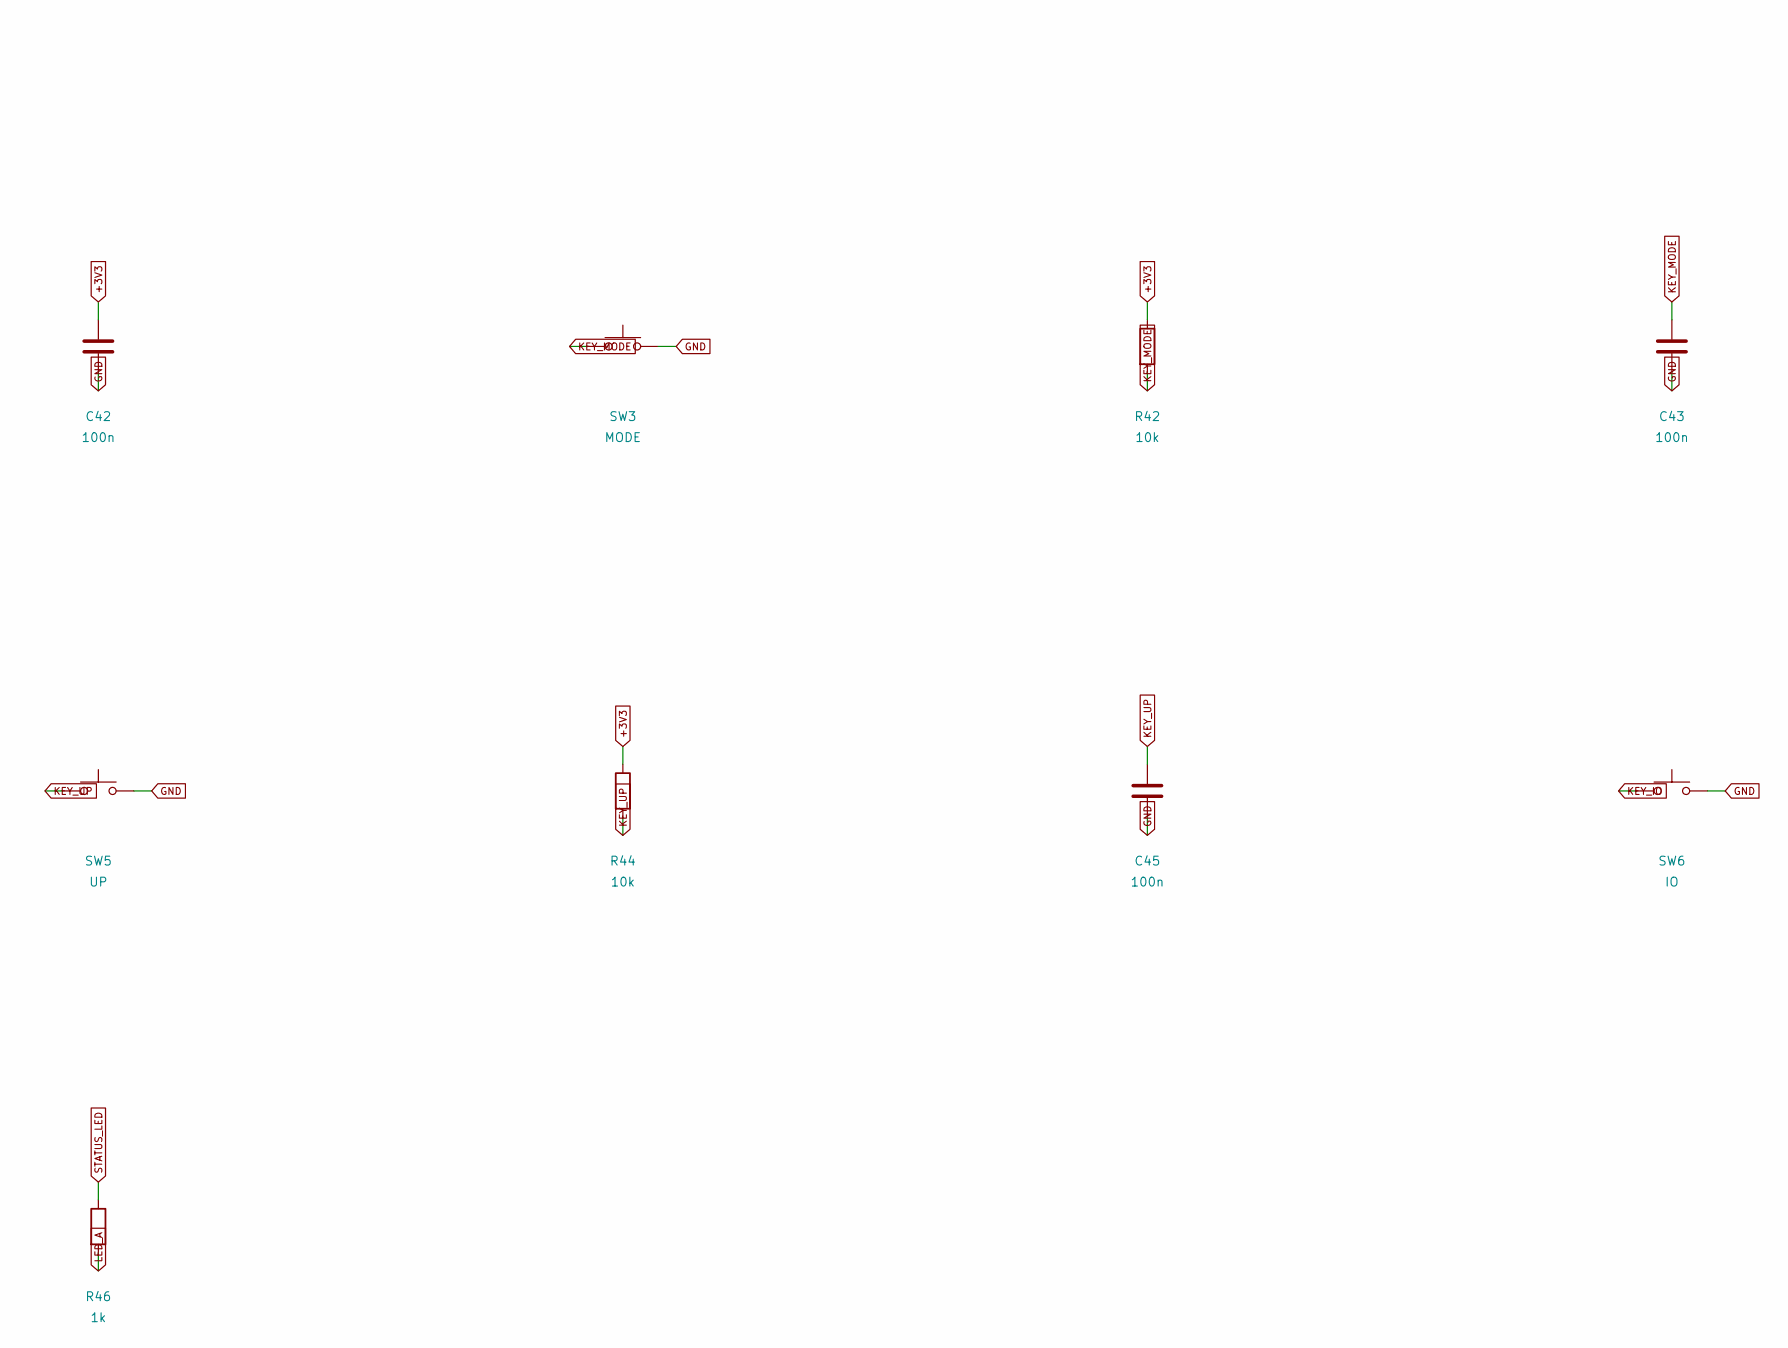
[picture p43: schematic ui.kicad_sch, VOICE PITCHER — UI, part in row 1, column 2]

Parts:
C42, C43, C44, C45, C46: 100n; Capacitor_SMD__C_0603_1608Metric; MPN CC0603KRX7R9BB104; LCSC C14663
D1: GREEN; LED_SMD__LED_0603_1608Metric; MPN LTST-C190KGKT
J4: OLED GND VCC SCL SDA; Connector_PinHeader_2.54mm__PinHeader_1x04_P2.54mm_Vertical; MPN 1x4 2.54mm OLED socket
R40, R41: 4.7k; Resistor_SMD__R_0603_1608Metric; MPN 0603WAF4701T5E; LCSC C23162
R42, R43, R44, R45: 10k; Resistor_SMD__R_0603_1608Metric; MPN 0603WAF1002T5E; LCSC C25804
R46: 1k; Resistor_SMD__R_0603_1608Metric; MPN 0603WAF1001T5E; LCSC C21190
SW3: MODE; Button_Switch_SMD__SW_SPST_TL3342; MPN TL3342F160QG
SW4: DOWN; Button_Switch_SMD__SW_SPST_TL3342; MPN TL3342F160QG
SW5: UP; Button_Switch_SMD__SW_SPST_TL3342; MPN TL3342F160QG
SW6: IO; Button_Switch_SMD__SW_SPST_TL3342; MPN TL3342F160QG

Connections:
+3V3: C42.1, J4.2, R40.1, R41.1, R42.1, R43.1, R44.1, R45.1; also elsewhere on the board
GND: C42.2, C43.2, C44.2, C45.2, C46.2, D1.1 (K), J4.1, SW3.2, SW4.2, SW5.2, SW6.2; also elsewhere on the board
I2C_SCL: J4.3, R40.2; also elsewhere on the board
I2C_SDA: J4.4, R41.2; also elsewhere on the board
KEY_DOWN: C44.1, R43.2, SW4.1; also elsewhere on the board
KEY_IO: C46.1, R45.2, SW6.1; also elsewhere on the board
KEY_MODE: C43.1, R42.2, SW3.1; also elsewhere on the board
KEY_UP: C45.1, R44.2, SW5.1; also elsewhere on the board
LED_A: D1.2 (A), R46.2
STATUS_LED: R46.1; also elsewhere on the board

Notes on the sheet:
All named nets are global. Unused pins are explicitly NC.
See docs/hardware.md for design assumptions and open validation items.

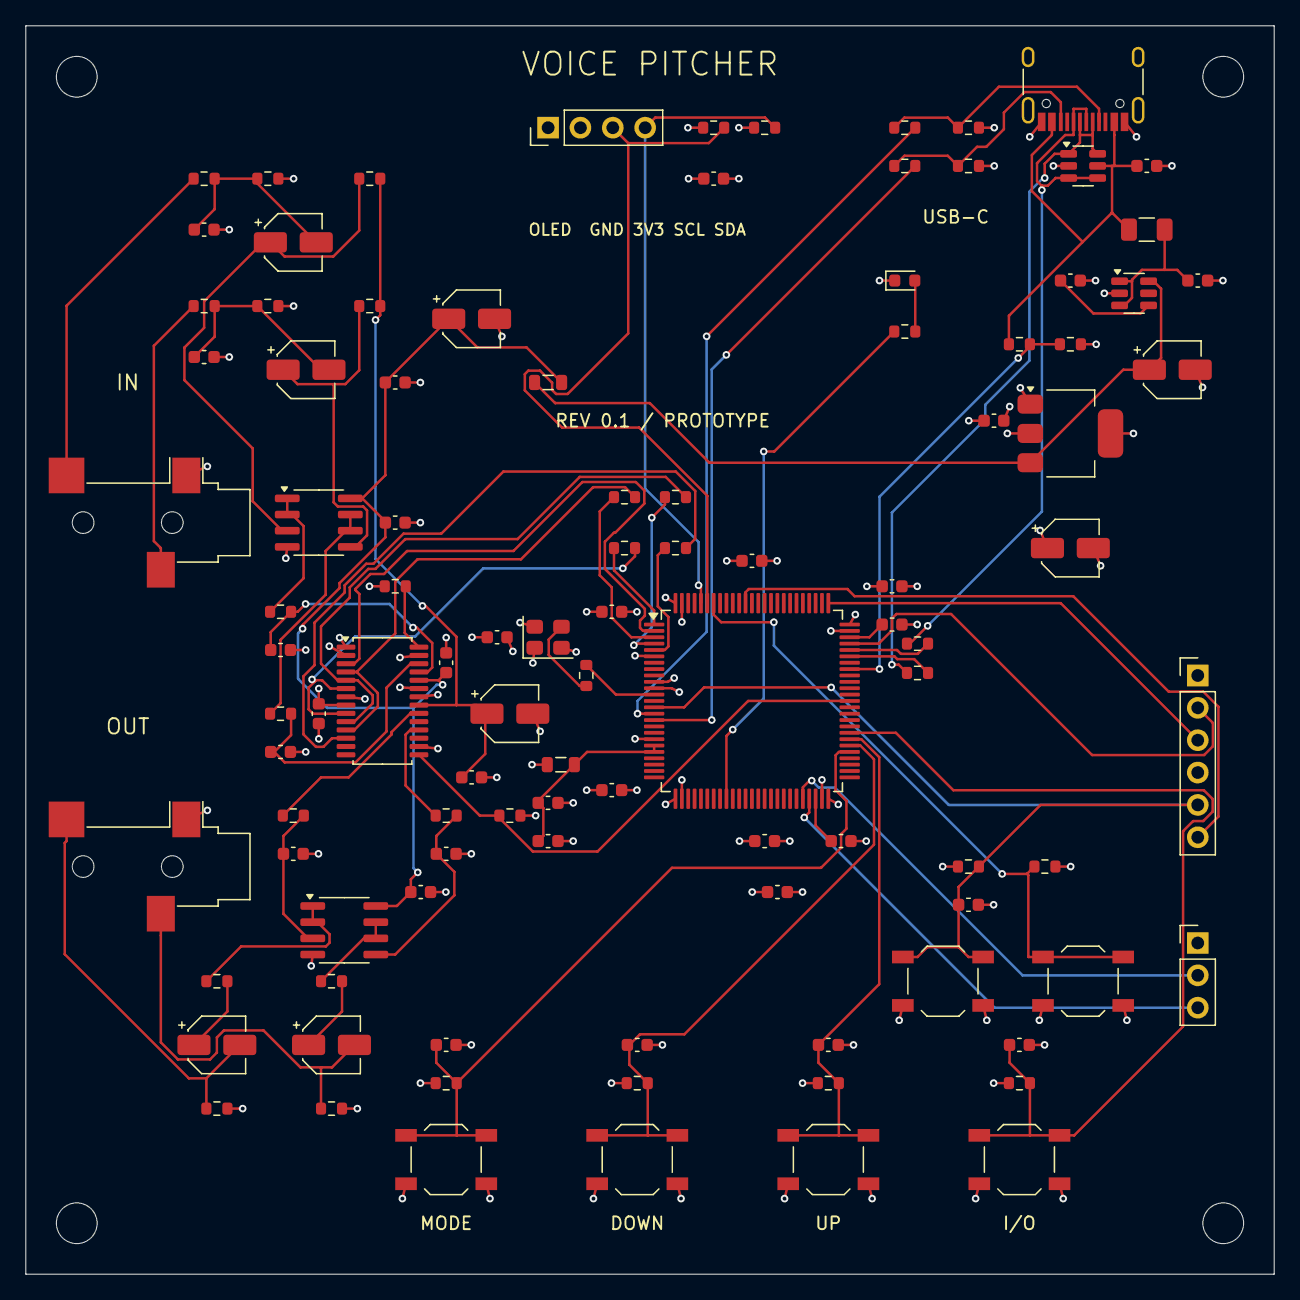
[picture p44: board voice_pitcher.kicad_pcb from above]

Board: 4 copper layers, 98.0 x 98.0 mm, 107 parts (0 on the bottom side), 68 nets.

Other parts of the board:
H1, H2, H3, H4: M3 NPTH; MountingHole__MountingHole_3.2mm_M3
