Xenoah/pcb_voice-pitcher/firmware/tusb_config.h

#ifndef VP_TUSB_CONFIG_H
#define VP_TUSB_CONFIG_H
#define CFG_TUSB_MCU OPT_MCU_STM32H7
#define CFG_TUSB_OS OPT_OS_NONE
#define CFG_TUSB_DEBUG 0
#define CFG_TUD_ENABLED 1
#define CFG_TUH_ENABLED 0
#define CFG_TUD_MAX_SPEED OPT_MODE_FULL_SPEED
#define CFG_TUD_ENDPOINT0_SIZE 64
#define CFG_TUD_CDC 0
#define CFG_TUD_MSC 0
#define CFG_TUD_HID 0
#define CFG_TUD_MIDI 0
#define CFG_TUD_VENDOR 0
#define CFG_TUD_AUDIO 1
#define CFG_TUSB_MEM_ALIGN __attribute__((aligned(4)))
#define CFG_TUD_AUDIO_FUNC_1_DESC_LEN 209
#define CFG_TUD_AUDIO_FUNC_1_N_FORMATS 1
#define CFG_TUD_AUDIO_FUNC_1_MAX_SAMPLE_RATE 48000
#define CFG_TUD_AUDIO_FUNC_1_N_CHANNELS_TX 2
#define CFG_TUD_AUDIO_FUNC_1_N_CHANNELS_RX 2
#define CFG_TUD_AUDIO_FUNC_1_FORMAT_1_N_BYTES_PER_SAMPLE_TX 3
#define CFG_TUD_AUDIO_FUNC_1_FORMAT_1_RESOLUTION_TX 24
#define CFG_TUD_AUDIO_FUNC_1_FORMAT_1_N_BYTES_PER_SAMPLE_RX 3
#define CFG_TUD_AUDIO_FUNC_1_FORMAT_1_RESOLUTION_RX 24
#define CFG_TUD_AUDIO_ENABLE_EP_IN 1
#define CFG_TUD_AUDIO_ENABLE_EP_OUT 1
#define CFG_TUD_AUDIO_ENABLE_FEEDBACK_EP 1
#define CFG_TUD_AUDIO_ENABLE_FEEDBACK_FORMAT_CORRECTION 1
#define CFG_TUD_AUDIO_FUNC_1_EP_IN_SZ_MAX 294
#define CFG_TUD_AUDIO_FUNC_1_EP_OUT_SZ_MAX 294
#define CFG_TUD_AUDIO_FUNC_1_EP_IN_SW_BUF_SZ 2352
#define CFG_TUD_AUDIO_FUNC_1_EP_OUT_SW_BUF_SZ 2352
#define CFG_TUD_AUDIO_FUNC_1_N_AS_INT 2
#define CFG_TUD_AUDIO_FUNC_1_CTRL_BUF_SZ 64
#endif
