Xenoah/pcb_voice-pitcher/(commit log)

2026-11-01 Add 98mm standalone voice DSP prototype with KiCad, firmware and manufacturing downloads
    [additional_parts.csv, analog.kicad_sch, bom_master.csv, codec.kicad_sch, jlc_bom.csv, mcu.kicad_sch, placement.kicad_pcb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]
2026-11-01 Verify Gerber layer metadata and omit unconfirmed fabrication stackup
    [voice_pitcher-B_Cu.gbl, voice_pitcher-B_Mask.gbs, voice_pitcher-Edge_Cuts.gm1, voice_pitcher-F_Cu.gtl, voice_pitcher-F_Mask.gts, voice_pitcher-F_Paste.gtp, voice_pitcher-F_Silkscreen.gto, voice_pitcher-NPTH.drl]
2026-11-01 Add complete CAD screenshot gallery and publishable prototype release
